Barbatronic/CDR-2027/DOCS/_posts/2026-09-21-elements-de-jeu.md

---
title: "Réception des éléments de jeu : boulets et pierres"
date: 2026-09-21
tags: [test]
description: "Premières observations sur les éléments de jeu reçus pour la Coupe de France de robotique 2027 : les boulets (balles de 45 mm) et les pierres (cartons de 32 × 11 × 11 cm)."
---

## Objectif

Je viens de recevoir les éléments de jeu, alors je note ici mes premières observations.

Petit point de vocabulaire : dans la nomenclature de la Coupe de France de robotique 2027, les balles de 45 mm s'appellent les « boulets » et les cartons de 32 × 11 × 11 cm les « pierres ».

## Premier élément : les boulets (balles de 45 mm)

### Commande des boulets

J'ai commandé sur Amazon des balles de magicien standard de 45 mm : [lien d'achat](https://amzn.to/4y9q3ZC).

### Réception des boulets

Les balles sont arrivées le 20 septembre dans un sachet sous vide, donc à la sortie elles étaient complètement compressées.

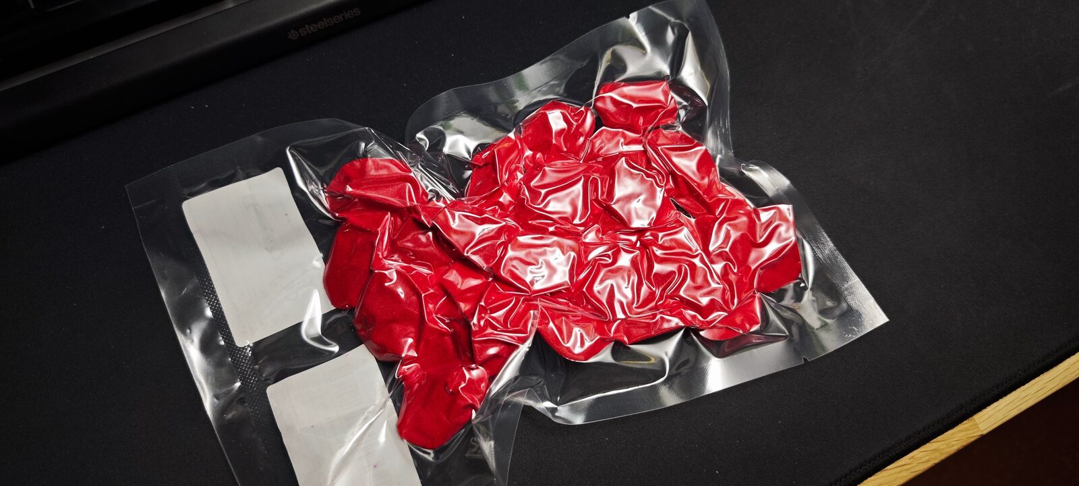
[picture p26: DOCS/assets/img/2026-09-21-elements-de-jeu/boulets-sachet-sous-vide.jpg]
Sachet sous vide contenant les balles compressées

*Le sachet sous vide à la réception.*

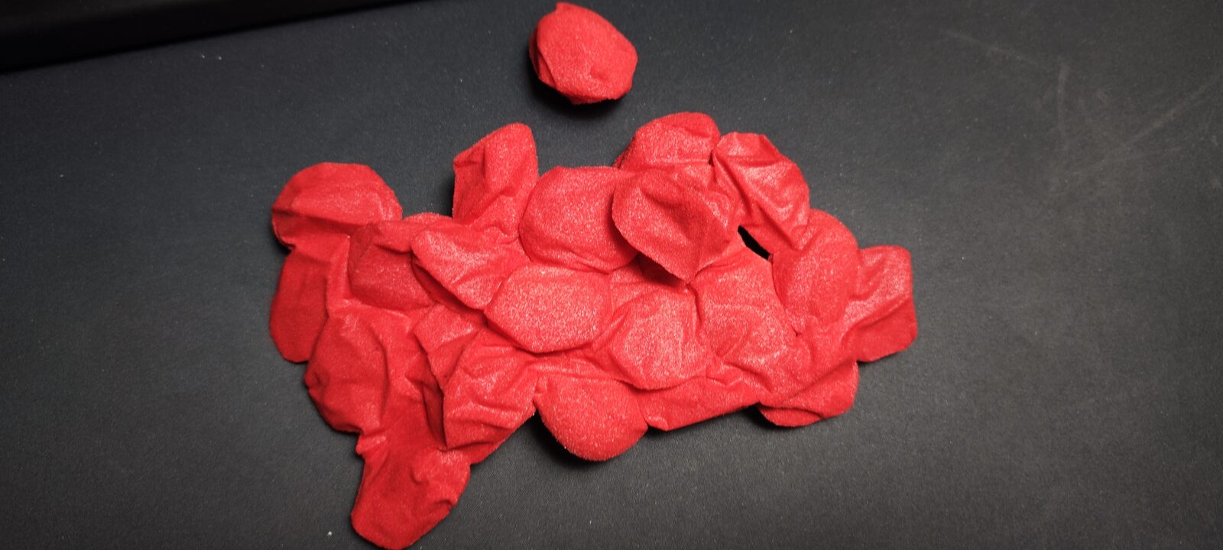
[picture p27: DOCS/assets/img/2026-09-21-elements-de-jeu/boulets-sortis-du-sachet.jpg]
Balles sorties du sachet, encore aplaties

*Les balles sorties du sachet, encore aplaties.*

### Reprise de forme

Je les ai simplement laissées au repos, sans rien faire de mon côté. Au bout d'une heure et demie à deux heures, elles avaient repris une forme à peu près sphérique.

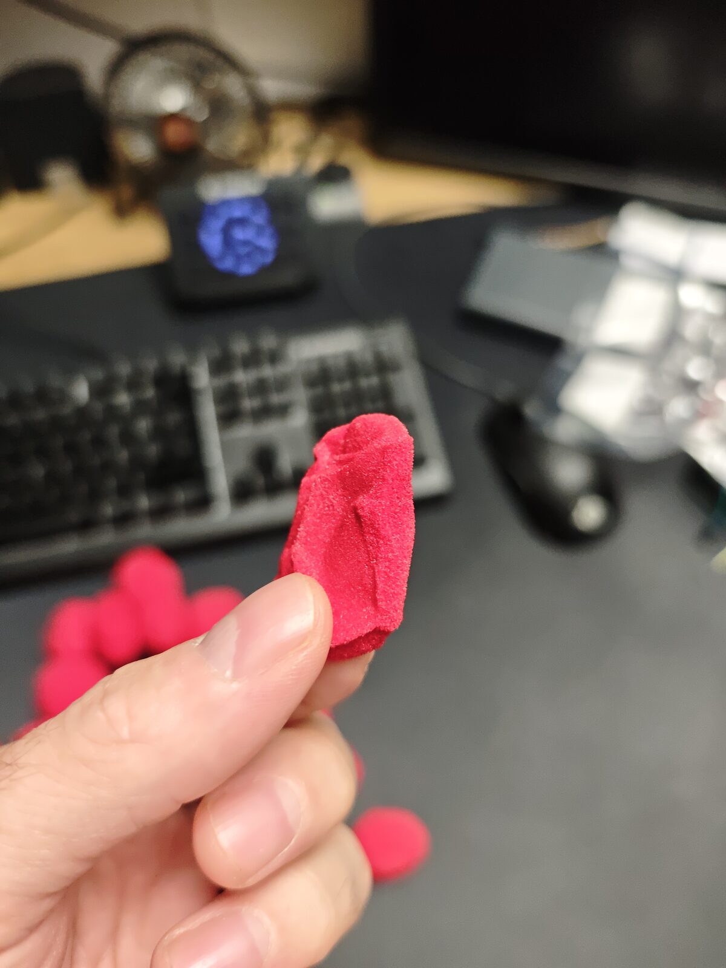
[picture p28: DOCS/assets/img/2026-09-21-elements-de-jeu/boulet-deforme-main.jpg]
Une balle déformée tenue entre les doigts

*Une balle encore déformée.*

### Mesures

Je les ai mesurées le lendemain de la réception, le 21 septembre, avec un pied à coulisse numérique.

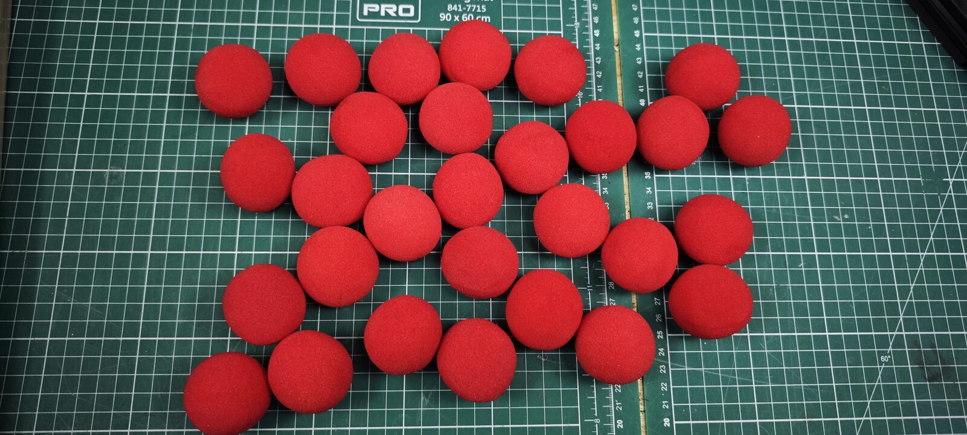
[picture p29: DOCS/assets/img/2026-09-21-elements-de-jeu/boulets-sur-tapis.jpg]
Les balles étalées sur un tapis de découpe

*Les balles après repos, étalées sur le tapis de découpe.*

Pour chaque balle, je fais trois mesures à des endroits différents.

#### Balle 1

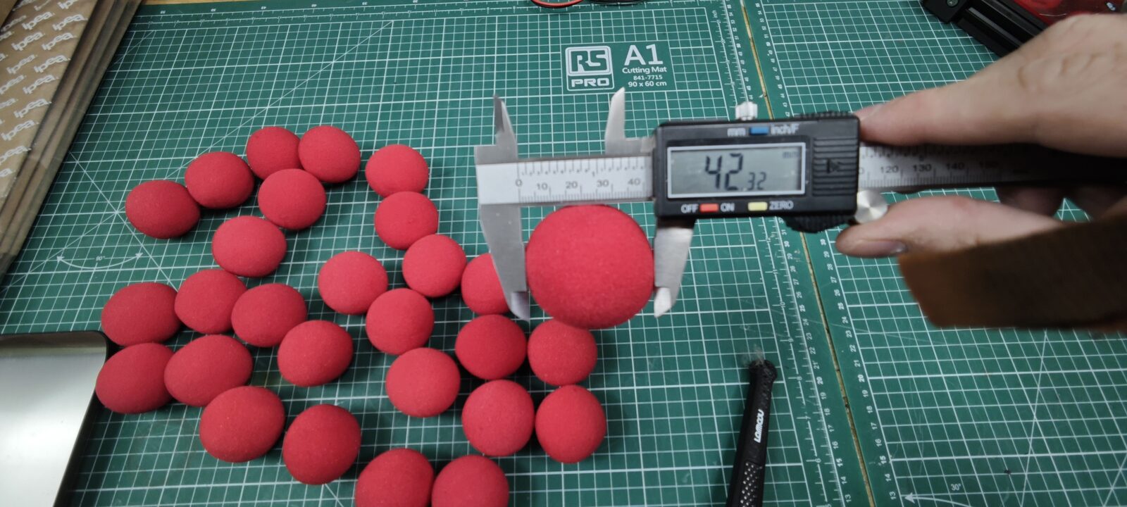
[picture p30: DOCS/assets/img/2026-09-21-elements-de-jeu/boulet-1-mesure-1.jpg]
Balle mesurée au pied à coulisse : 42,32 mm

*Mesure 1 : 42,32 mm.*

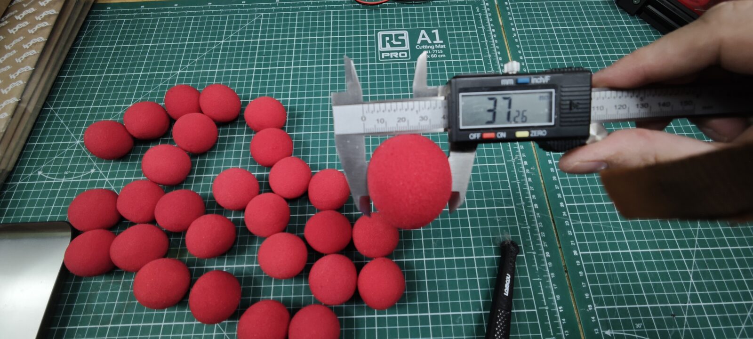
[picture p31: DOCS/assets/img/2026-09-21-elements-de-jeu/boulet-1-mesure-2.jpg]
Balle mesurée au pied à coulisse : 37,26 mm

*Mesure 2 : 37,26 mm.*

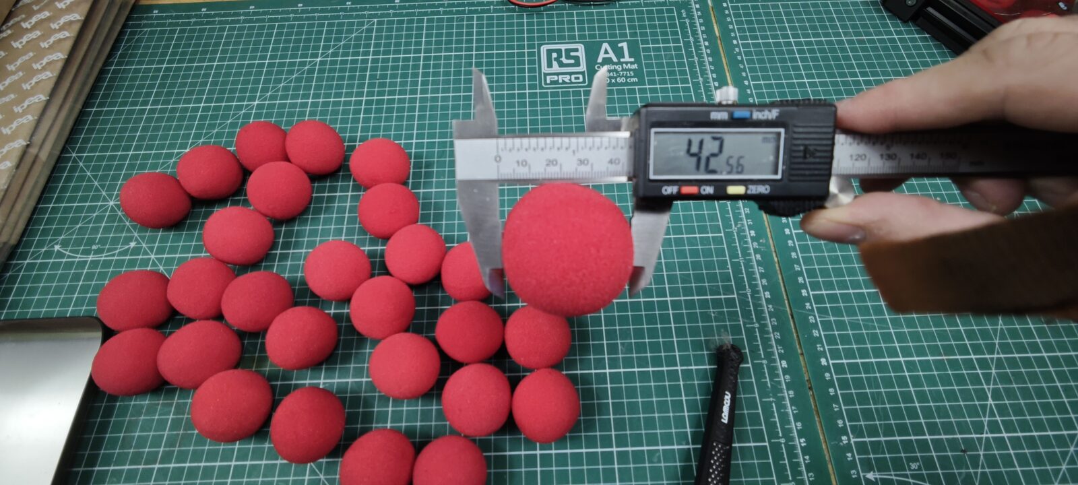
[picture p32: DOCS/assets/img/2026-09-21-elements-de-jeu/boulet-1-mesure-3.jpg]
Balle mesurée au pied à coulisse : 42,56 mm

*Mesure 3 : 42,56 mm.*

#### Balle 2

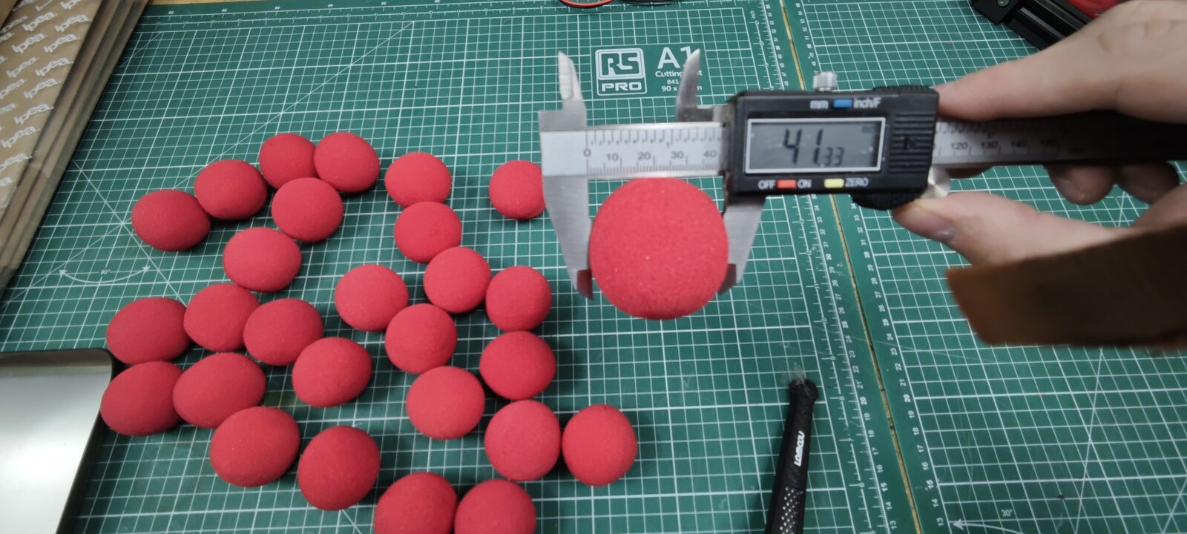
[picture p33: DOCS/assets/img/2026-09-21-elements-de-jeu/boulet-2-mesure-1.jpg]
Balle 2 mesurée au pied à coulisse : 41,33 mm

*Mesure 1 : 41,33 mm.*

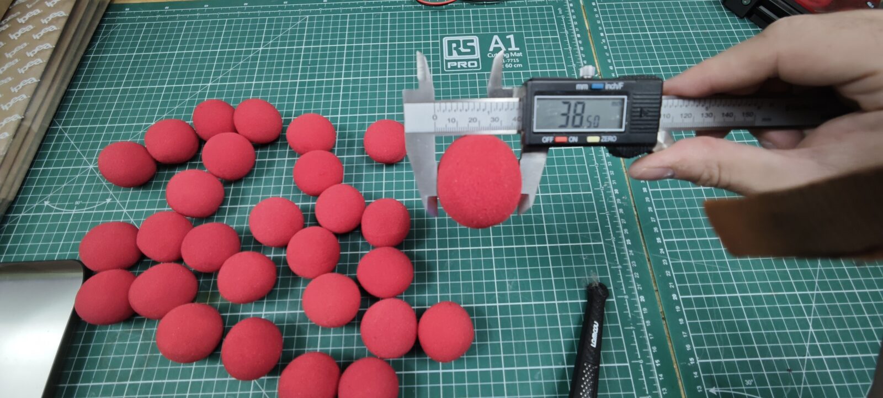
[picture p34: DOCS/assets/img/2026-09-21-elements-de-jeu/boulet-2-mesure-2.jpg]
Balle 2 mesurée au pied à coulisse : 38,50 mm

*Mesure 2 : 38,50 mm.*

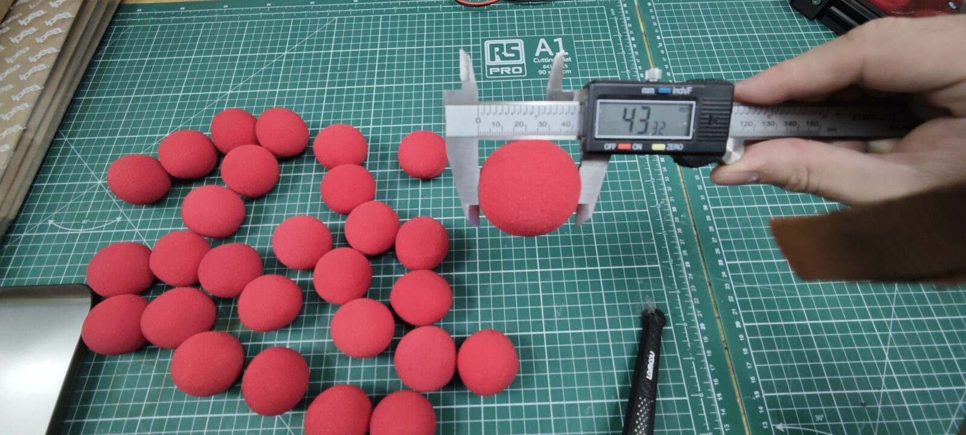
[picture p35: DOCS/assets/img/2026-09-21-elements-de-jeu/boulet-2-mesure-3.jpg]
Balle 2 mesurée au pied à coulisse : 43,32 mm

*Mesure 3 : 43,32 mm.*

#### Balle 3

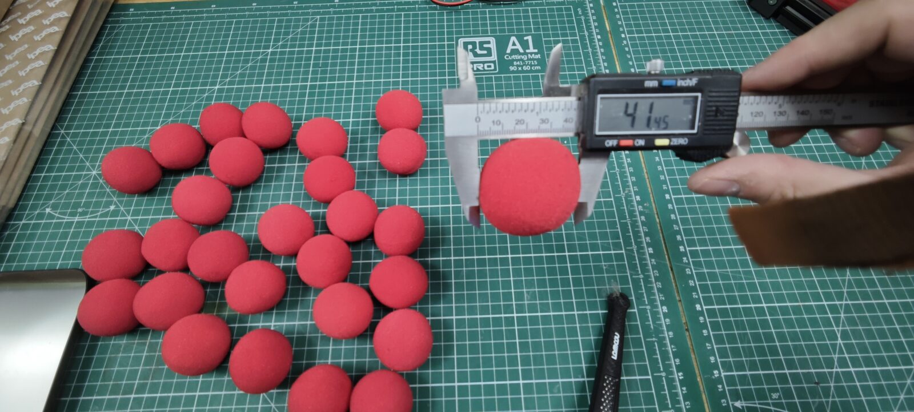
[picture p36: DOCS/assets/img/2026-09-21-elements-de-jeu/boulet-3-mesure-1.jpg]
Balle 3 mesurée au pied à coulisse : 41,45 mm

*Mesure 1 : 41,45 mm.*

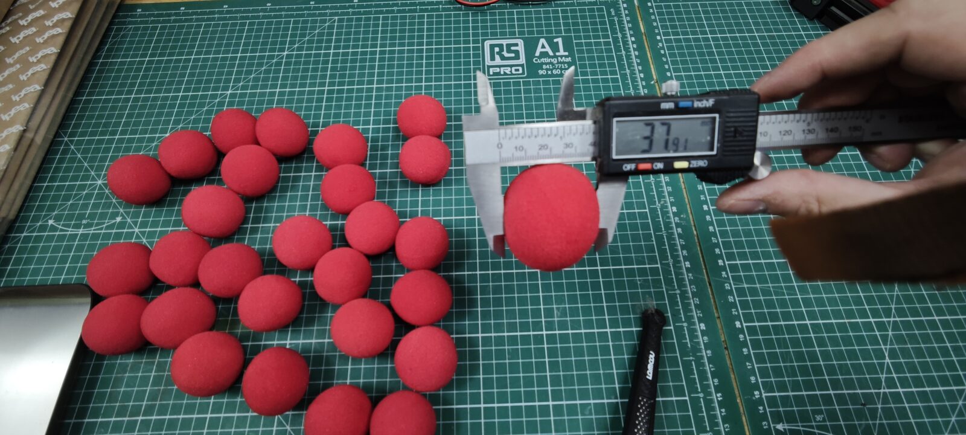
[picture p37: DOCS/assets/img/2026-09-21-elements-de-jeu/boulet-3-mesure-2.jpg]
Balle 3 mesurée au pied à coulisse : 37,91 mm

*Mesure 2 : 37,91 mm.*

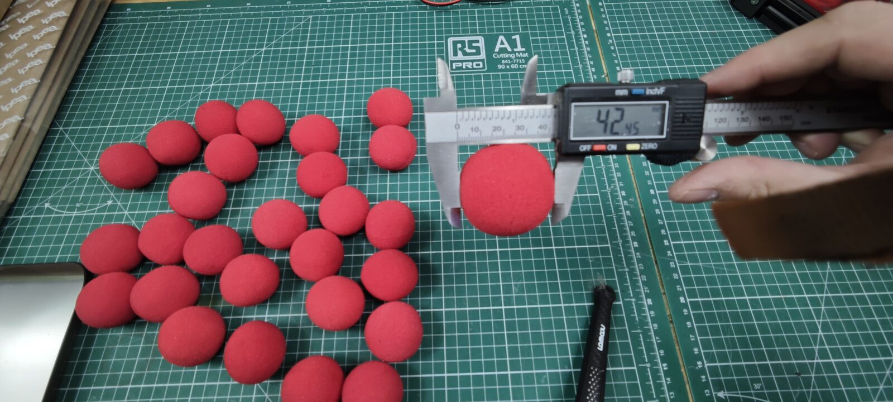
[picture p38: DOCS/assets/img/2026-09-21-elements-de-jeu/boulet-3-mesure-3.jpg]
Balle 3 mesurée au pied à coulisse : 42,45 mm

*Mesure 3 : 42,45 mm.*

#### Récapitulatif

| Balle | Mesure 1 | Mesure 2 | Mesure 3 | Écart max. |
|---|---|---|---|---|
| 1 | 42,32 mm | 37,26 mm | 42,56 mm | 5,30 mm |
| 2 | 41,33 mm | 38,50 mm | 43,32 mm | 4,82 mm |
| 3 | 41,45 mm | 37,91 mm | 42,45 mm | 4,54 mm |

Sur les trois balles, toutes les mesures sont sous les 45 mm (43,32 mm au maximum), et les balles ne sont clairement pas rondes : pour une même balle, l'écart entre la plus petite et la plus grande mesure va de 4,54 mm à 5,30 mm.

### Poids des boulets

Les balles sont très légères, alors je les ai pesées par groupes de trois, avec à chaque fois trois balles différentes. La balance est précise au centième de gramme.

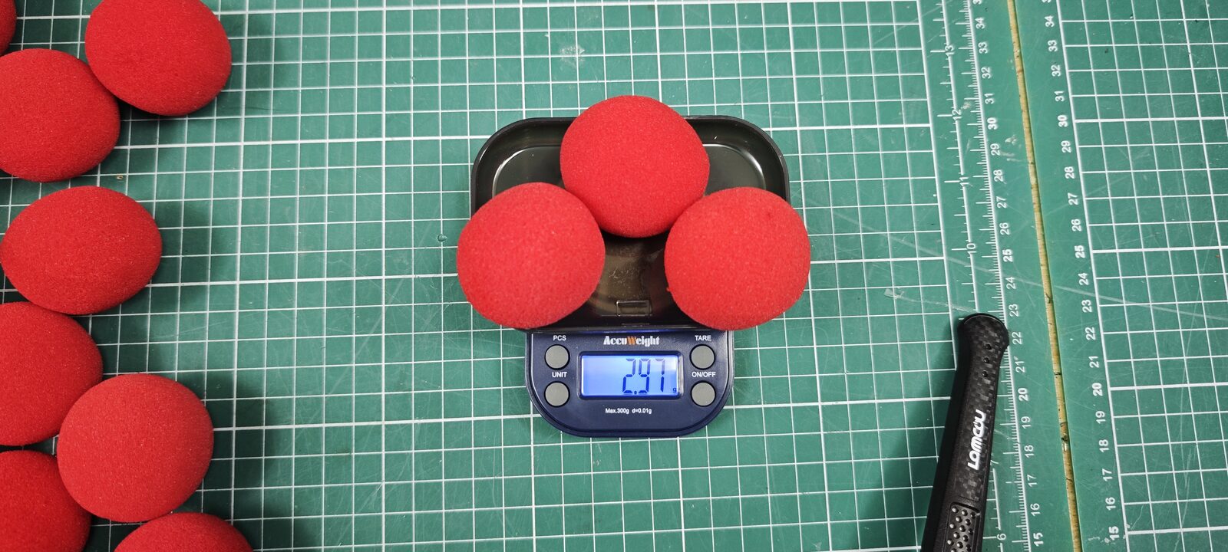
[picture p39: DOCS/assets/img/2026-09-21-elements-de-jeu/boulets-pesee-1.jpg]
Pesée 1 : trois balles sur la balance, 2,97 g

*Pesée 1 : 2,97 g pour trois balles.*

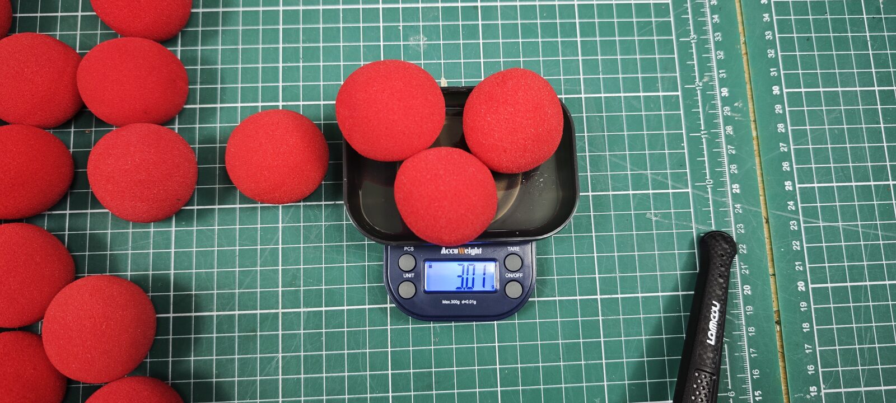
[picture p40: DOCS/assets/img/2026-09-21-elements-de-jeu/boulets-pesee-2.jpg]
Pesée 2 : trois balles sur la balance, 3,01 g

*Pesée 2 : 3,01 g pour trois balles.*

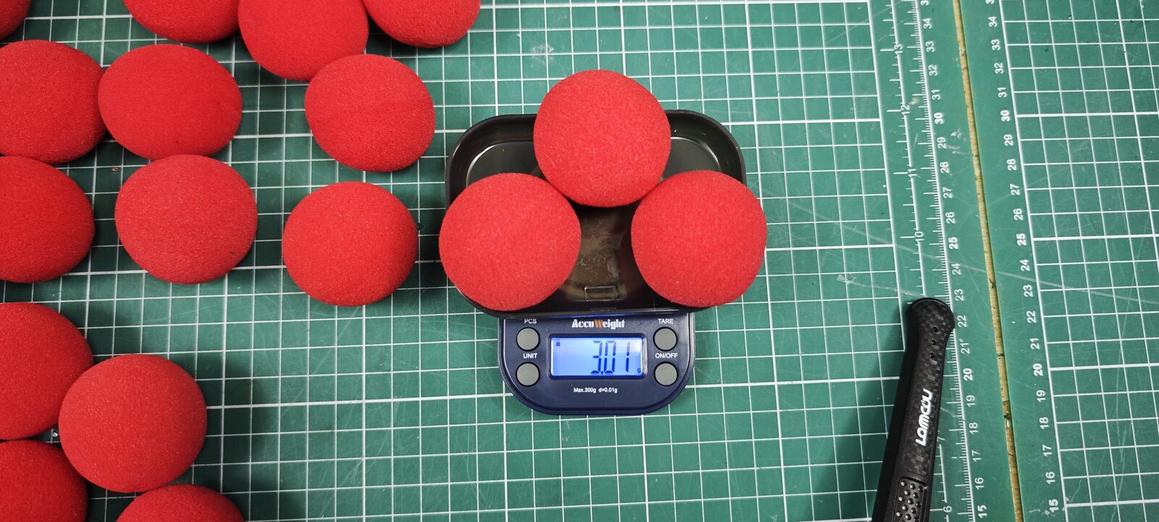
[picture p41: DOCS/assets/img/2026-09-21-elements-de-jeu/boulets-pesee-3.jpg]
Pesée 3 : trois balles sur la balance, 3,01 g

*Pesée 3 : 3,01 g pour trois balles.*

| Pesée | Masse de 3 balles | Masse moyenne par balle |
|---|---|---|
| 1 | 2,97 g | 0,99 g |
| 2 | 3,01 g | 1,00 g |
| 3 | 3,01 g | 1,00 g |

Au total, ça fait 8,99 g pour 9 balles, soit environ 1 g par balle.

## Deuxième élément : les pierres (cartons de 32 × 11 × 11 cm)

### Commande des pierres

Le deuxième élément de jeu est un carton, qui doit normalement faire 32 × 11 × 11 cm.

Sur le lien d'achat, l'annonce parle de cartons de 30 × 10 × 10 cm : [lien d'achat](https://amzn.to/4hB10bT). J'ai pris le risque de les commander pour tester, en me disant que c'étaient peut-être les dimensions intérieures.

### Réception des pierres

En fait, sur cette référence, le carton reçu est celui du fabricant Raja, référence BLFA01. Les dimensions sont marquées dessus : 31 × 10,5 × 10,5 cm, et ce sont bien celles qu'on retrouve chez le fabricant.

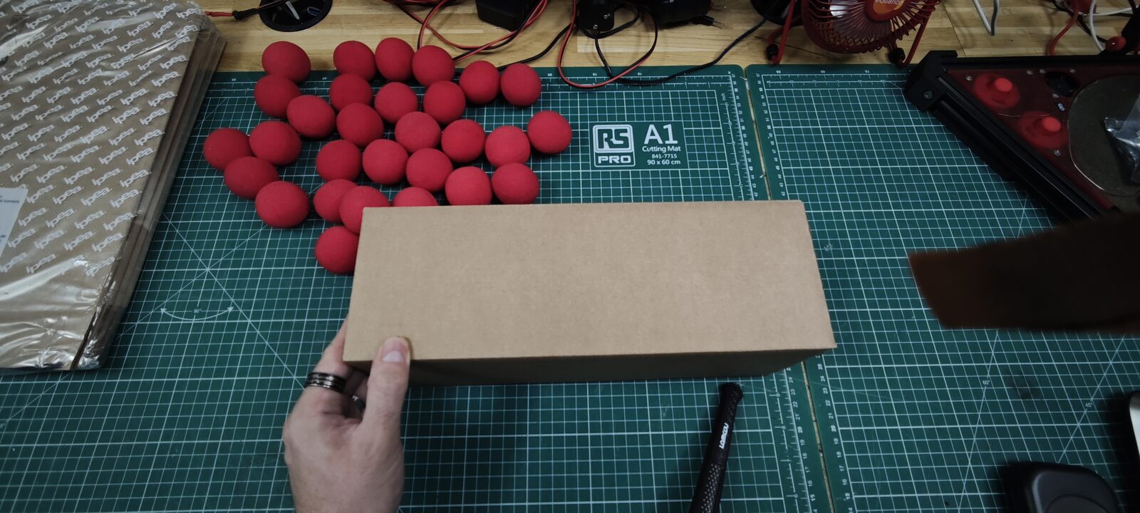
[picture p42: DOCS/assets/img/2026-09-21-elements-de-jeu/pierre-sur-tapis.jpg]
Le carton posé sur le tapis de découpe

*Le carton posé sur le tapis de découpe.*

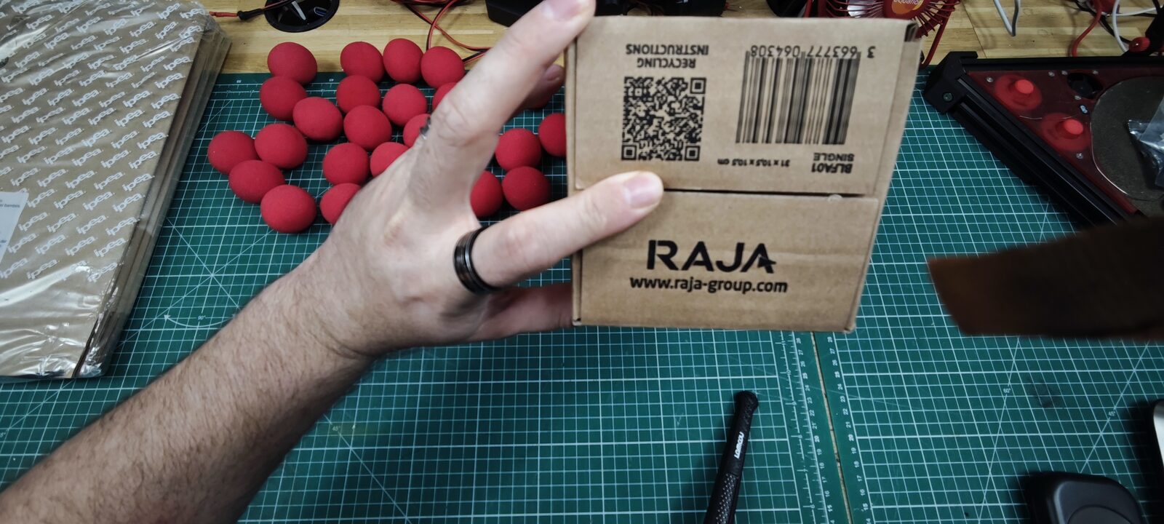
[picture p43: DOCS/assets/img/2026-09-21-elements-de-jeu/pierre-extremite-etiquette.jpg]
Une extrémité du carton, avec le logo Raja et l'étiquette

*Une extrémité du carton, avec le logo Raja et l'étiquette.*

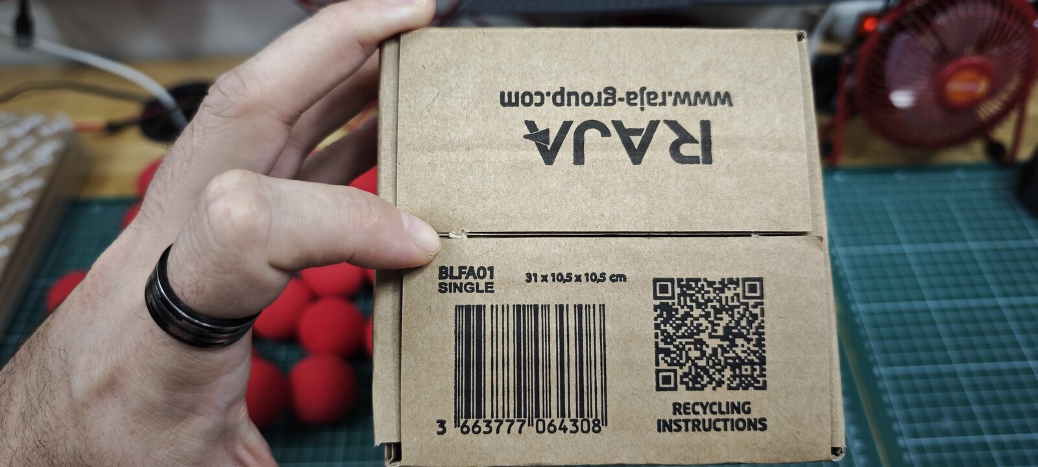
[picture p44: DOCS/assets/img/2026-09-21-elements-de-jeu/pierre-etiquette-gros-plan.jpg]
Gros plan sur l'étiquette : BLFA01, 31 x 10,5 x 10,5 cm

*Gros plan sur l'étiquette : BLFA01, 31 x 10,5 x 10,5 cm.*

### Mesure au mètre

J'ai mesuré le carton au mètre ruban, à l'extérieur : il fait environ 32 cm de long et 11 cm de côté.

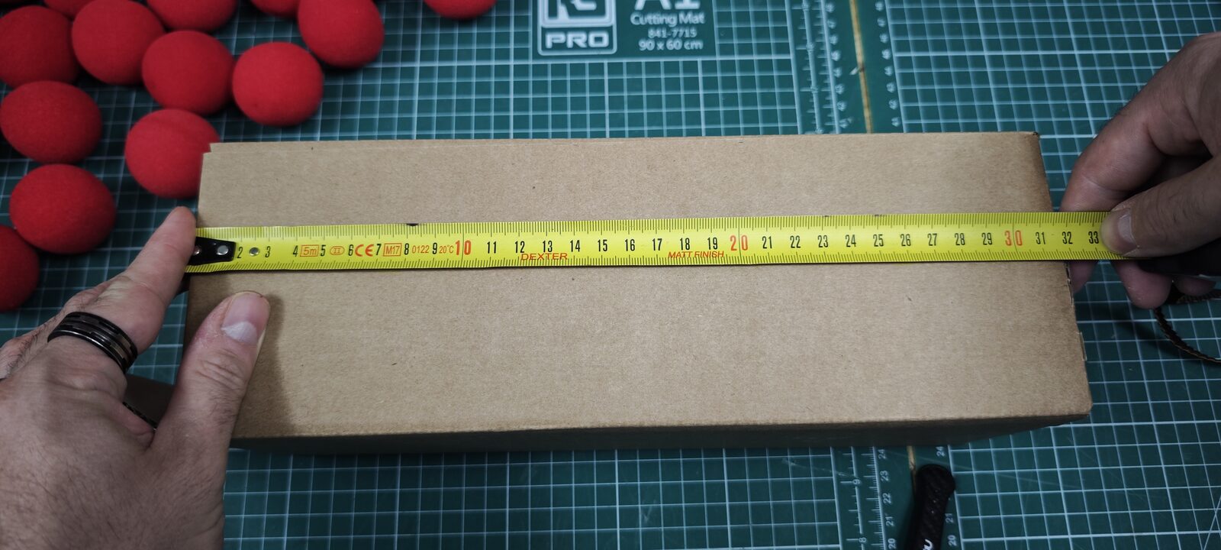
[picture p45: DOCS/assets/img/2026-09-21-elements-de-jeu/pierre-mesure-longueur.jpg]
Mesure de la longueur du carton au mètre ruban : environ 32 cm

*Longueur : environ 32 cm.*

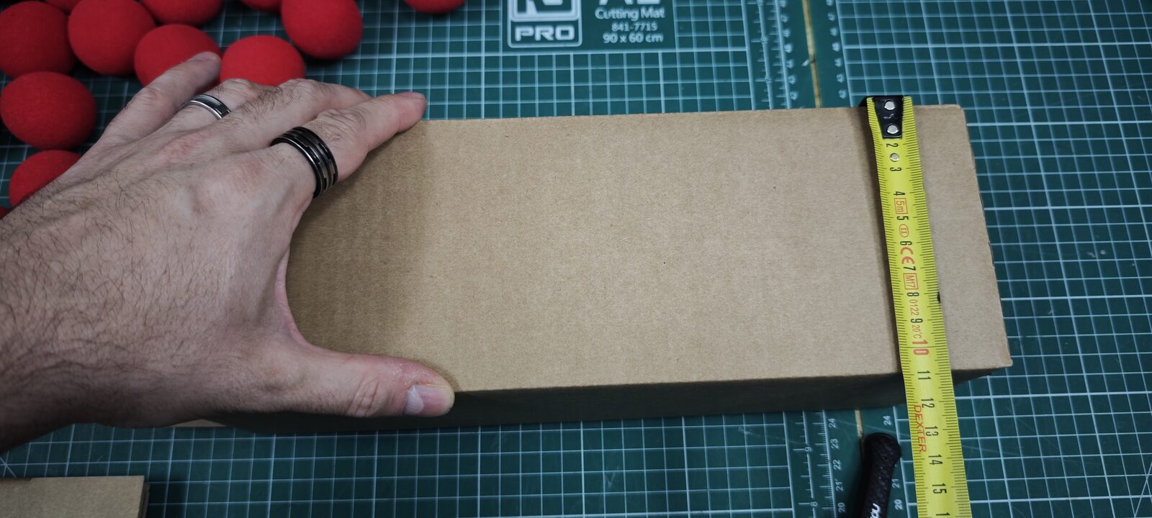
[picture p46: DOCS/assets/img/2026-09-21-elements-de-jeu/pierre-mesure-cote.jpg]
Mesure d'un côté du carton au mètre ruban : environ 11 cm

*Côté : environ 11 cm.*

### Comparaison des dimensions

| Source | Dimensions | Écart avec l'élément de jeu |
|---|---|---|
| Élément de jeu attendu | 32 × 11 × 11 cm | – |
| Annonce du lien d'achat | 30 × 10 × 10 cm | −2 × −1 × −1 cm |
| Marquage du carton (Raja BLFA01) | 31 × 10,5 × 10,5 cm | −1 × −0,5 × −0,5 cm |
| Mesure au mètre (dimensions extérieures) | environ 32 × 11 cm  | environ 0 cm |

Bref, quelles que soient les dimensions annoncées par le lien d'achat ou marquées sur le carton, il fait bien environ 32 × 11 cm à l'extérieur, et c'est ce qu'on attend d'une pierre.

### Aspect extérieur

**Petits côtés.** Sur un des petits côtés, le carton est un peu renfoncé, et c'est très difficile de le rendre complètement plan. Il faudra en tenir compte pour la manipulation et pour la dépose de la pierre.

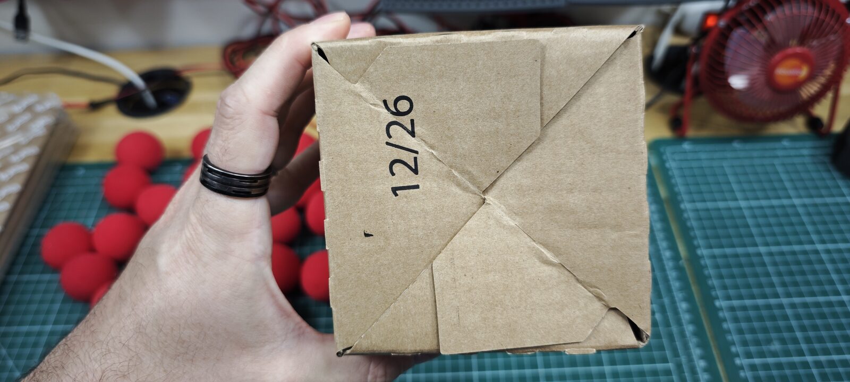
[picture p47: DOCS/assets/img/2026-09-21-elements-de-jeu/pierre-petit-cote.jpg]
Un petit côté du carton, avec les rabats repliés

*Un petit côté : les rabats repliés laissent des plis et la face n'est pas plane.*

**Longs côtés.** Sur les longs côtés, rien à dire : le carton est plutôt rigide et plan. Il y a un petit surplus dû au rabat d'un côté, mais il se fait sur une arête et il ne semble pas gênant a priori.

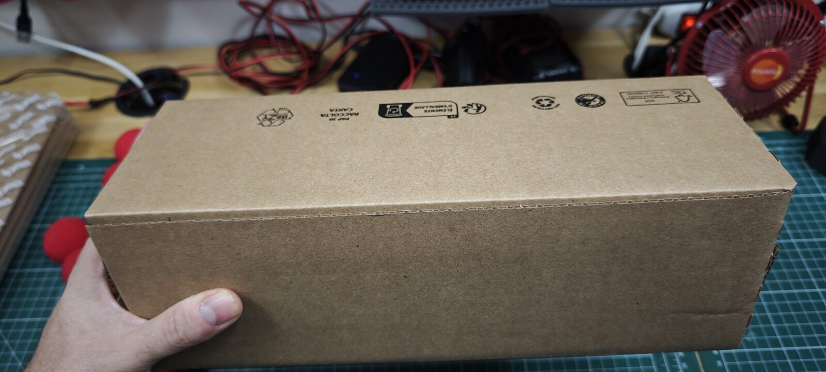
[picture p48: DOCS/assets/img/2026-09-21-elements-de-jeu/pierre-long-cote-rabat.jpg]
Un long côté du carton, avec le recouvrement du rabat

*Un long côté : le recouvrement du rabat se voit le long d'une arête.*

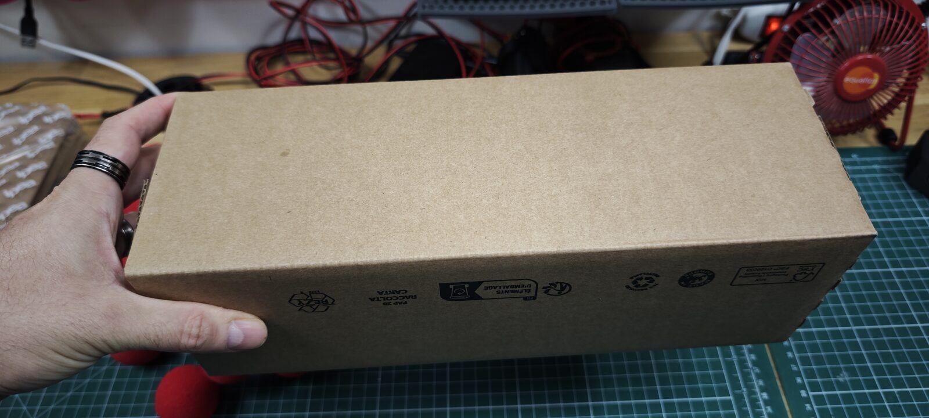
[picture p49: DOCS/assets/img/2026-09-21-elements-de-jeu/pierre-long-cote-marquages.jpg]
Un long côté du carton, avec les marquages d'emballage

*Un long côté, avec les marquages d'emballage.*

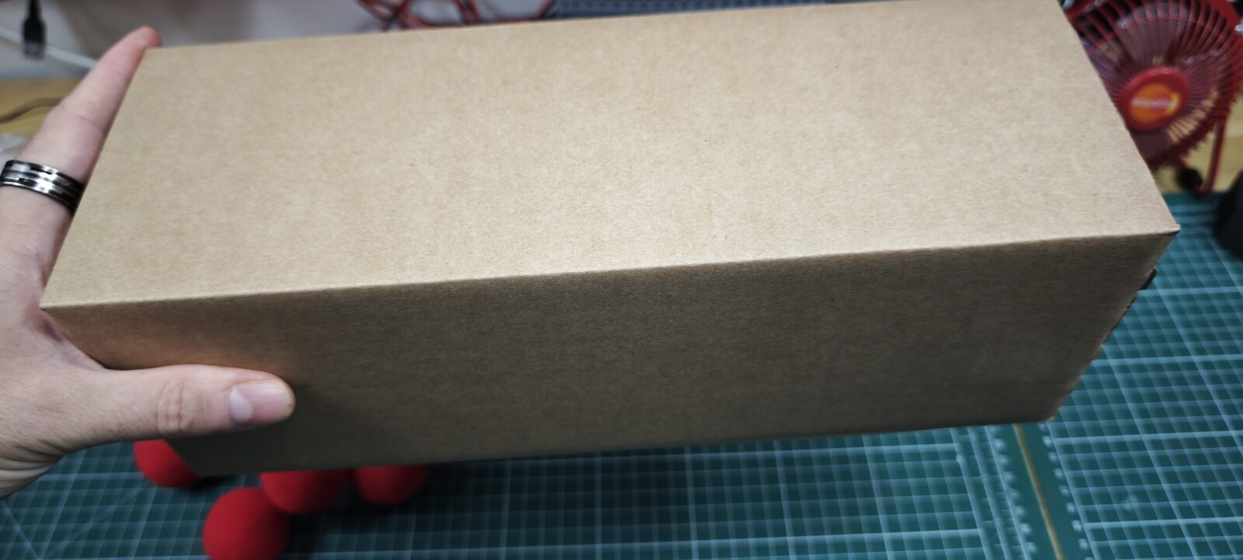
[picture p50: DOCS/assets/img/2026-09-21-elements-de-jeu/pierre-long-cote-plan.jpg]
Un long côté du carton, plan

*Un long côté, plan.*

### Poids des pierres

D'après le règlement, une pierre pèse environ 90 g. J'ai pesé un carton : la balance affiche 76 g, soit 14 g de moins que les 90 g attendus (environ 16 %). Mes cartons sont donc plus légers que prévu.

Il y a une explication possible : je n'ai pas encore mis sur ces cartons la surface autocollante avec les tags de reconnaissance. Or les pierres portent du vinyle avec des QR codes, et ce vinyle peut ajouter du poids. C'est peut-être en partie ce qui explique la différence.

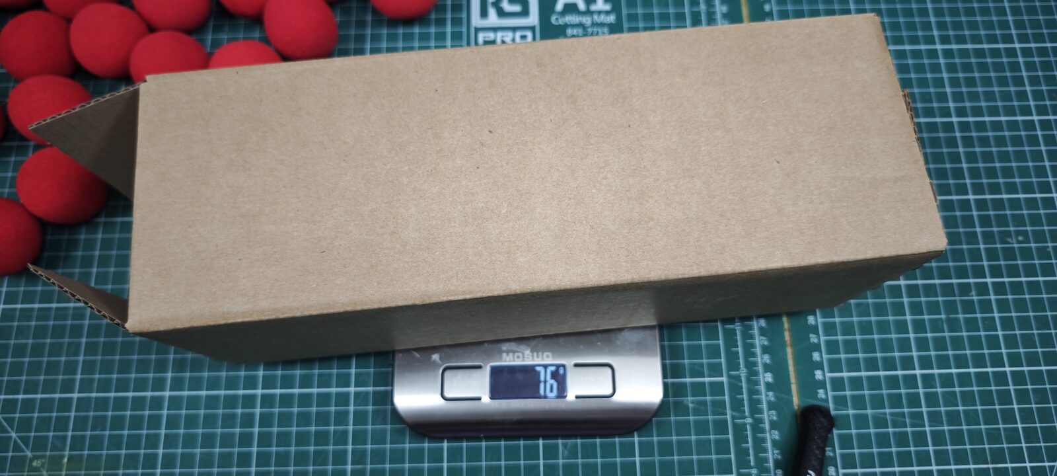
[picture p51: DOCS/assets/img/2026-09-21-elements-de-jeu/pierre-pesee.jpg]
Le carton posé sur une balance, 76 g

*Le carton sur la balance : 76 g.*

### Empilement de trois pierres

J'ai empilé trois cartons, comme ils seront sur le terrain, à côté de mon robot de l'année dernière pour donner une idée de l'échelle.

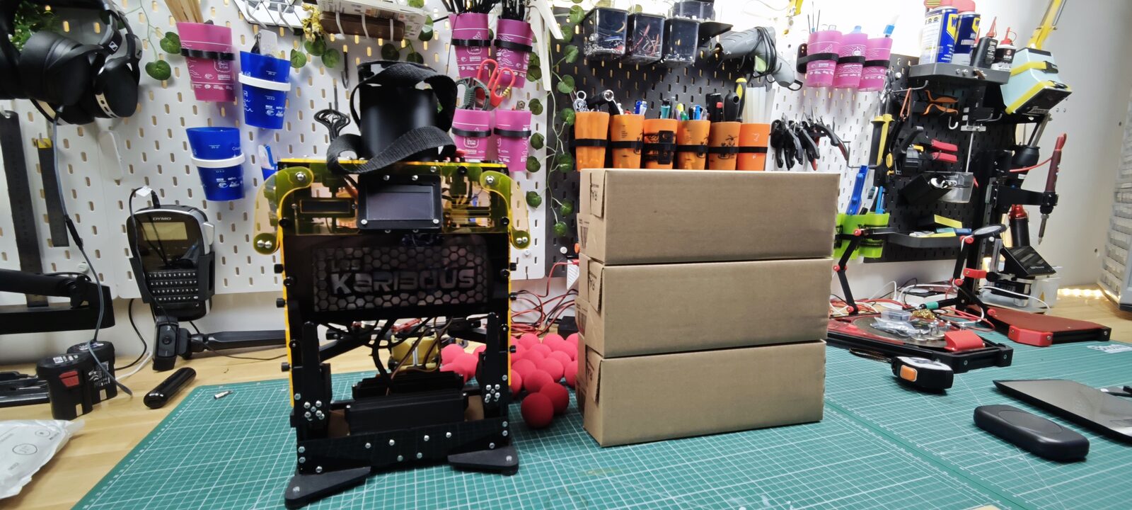
[picture p52: DOCS/assets/img/2026-09-21-elements-de-jeu/pierres-empilees-face.jpg]
Trois cartons empilés à côté du robot de l'année dernière, vue de face

*Les trois cartons empilés à côté de mon robot de l'année dernière, vue de face.*

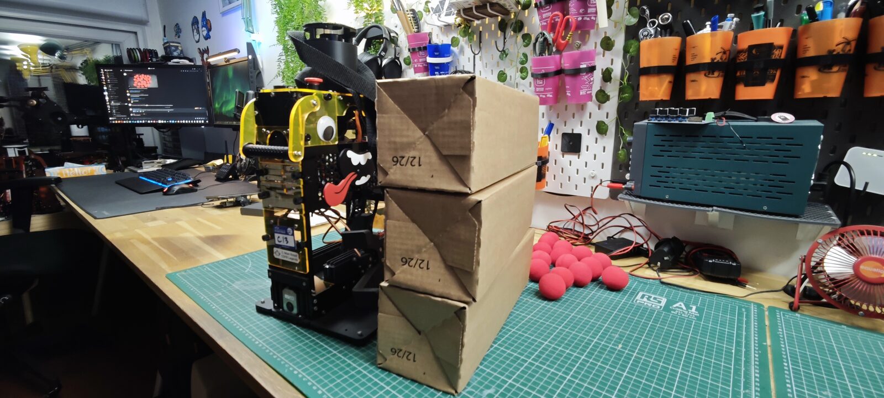
[picture p53: DOCS/assets/img/2026-09-21-elements-de-jeu/pierres-empilees-trois-quarts.jpg]
Trois cartons empilés à côté du robot de l'année dernière, vue de trois quarts

*Les mêmes, vus de trois quarts : on voit les rabats repliés en bout de carton.*

Ici, j'ai fermé chaque carton en croisant les rabats à chaque bout. Je ne sais pas comment les cartons seront fermés sur le terrain : scotchés pour être complètement fermés, collés, ou avec des rabats croisés comme dans mon montage ?

Selon la façon dont le carton est fabriqué, il est plus ou moins trapézoïdal, ou au contraire bien rectangulaire et droit. Du coup, une fois empilés par trois, on peut avoir une légère courbure, avec un mur qui n'est pas parfaitement droit. Il faudra en tenir compte dans la conception.

Autre point : les cartons glissent assez facilement les uns sur les autres. Là aussi, il faudra en tenir compte dans la conception, surtout si on veut une prise par ventouse.

#### Essai de tir sur le mur

J'ai envoyé des balles en mousse, à environ 80 cm, le plus fort possible, directement sur le mur de trois cartons, pour voir s'il tombait. Résultat : il ne tombe pas du tout. Un léger mouvement mais à peine. Je doute qu'à 2m de distance et en cloche les balles arrivent à détruire une construction adverse.

<video controls preload="metadata" playsinline width="100%">
  <source src="{{ '/assets/img/2026-09-21-elements-de-jeu/pierres-tir-sur-le-mur.mp4' | relative_url }}" type="video/mp4">
  Votre navigateur ne sait pas lire cette vidéo.
</video>

*Tirs de balles en mousse sur le mur de trois cartons : il reste debout.*

Une seconde vidéo, plus pour la blague, montre que je tape vraiment très fort : j'essaie réellement de les renverser :D

<video controls preload="metadata" playsinline width="100%">
  <source src="{{ '/assets/img/2026-09-21-elements-de-jeu/pierres-tir-demonstration.mp4' | relative_url }}" type="video/mp4">
  Votre navigateur ne sait pas lire cette vidéo.
</video>

## Conclusion

**Boulets :** Il va falloir que je fasse un essai de lancer de balles avec deux moteurs, pour voir ce que ça donne. Mais clairement, on ne peut pas compter sur la sphéricité des balles.

**Pierres :** Les murs de trois me semblent faciles à prendre, et il existe pas mal de solutions possibles. En revanche, le positionnement en colonne, donc bien droit et à la verticale, me semble assez aléatoire, selon le choix des côtés du carton.

Il reste une crainte : que les cartons s'abîment au fur et à mesure. Je fais confiance à l'organisation de la Coupe pour le repérer et les changer si nécessaire.

Enfin, je n'ai pas encore mis la surface autocollante avec les tags de reconnaissance sur mes cartons. Ça va probablement aussi changer leur comportement.
