Barbatronic/CDR-2027/DOCS/_posts/2026-09-22-portes-et-colonnes.md

---
title: "Essais des éléments de jeu : portes et colonnes"
date: 2026-09-22
tags: [test]
description: "Premiers essais des portes et des colonnes, éléments de jeu de la Coupe de France de robotique 2027."
---

## Objectif

À la demande d'Astérix (RCVA) sur le Discord de la coupe, j'ai fait quelques essais rapides sur deux autres constructions possibles avec les pierres : la porte et la tour.

## Premier élément : la porte

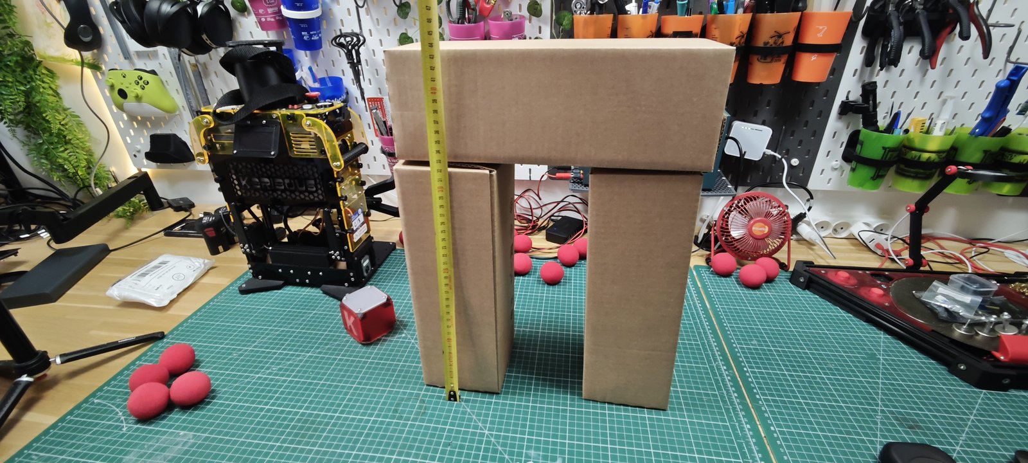
[picture p58: DOCS/assets/img/2026-09-22-portes-et-colonnes/porte-vue-ensemble.jpg]
Vue d'ensemble de la porte en construction, mesurée au mètre ruban

*La porte en construction, mesurée au mètre ruban.*

En l'état, j'arrive à une hauteur de 43,9 cm, à cause du renflement du carton sur le dessus.

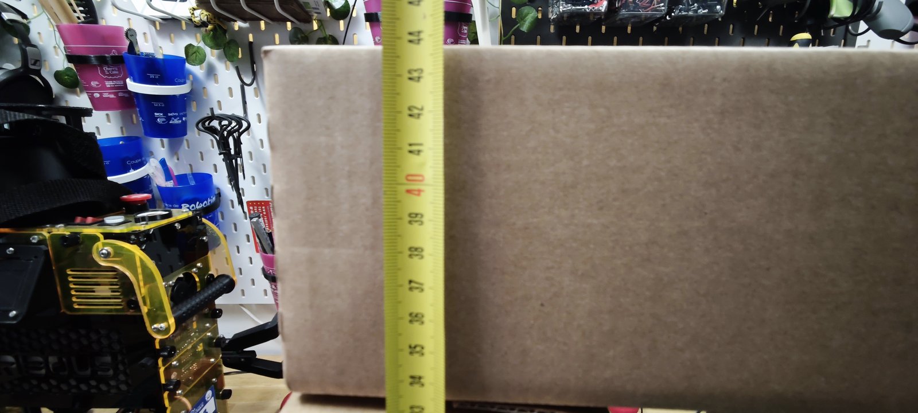
[picture p59: DOCS/assets/img/2026-09-22-portes-et-colonnes/porte-mesure-hauteur.jpg]
Gros plan sur la mesure au mètre ruban, un peu en dessous de 44 cm

*Gros plan sur la mesure : environ 43,9 cm.*

L'ensemble tient, mais on sent qu'il ne faut pas grand-chose pour que ça tombe :D

## Deuxième élément : la tour

J'ai aussi testé de lancer des balles sur une tour.

<video controls preload="metadata" playsinline width="100%">
  <source src="{{ '/assets/img/2026-09-22-portes-et-colonnes/colonne-tir-balles.mp4' | relative_url }}" type="video/mp4">
  Votre navigateur ne sait pas lire cette vidéo.
</video>

*Tirs de balles en mousse sur une tour.*

C'est plus instable qu'un mur, évidemment, mais je doute qu'une balle lancée depuis le terrain ou par un PAMI puisse vraiment impacter la construction. Par contre, selon l'état du carton sur le petit côté (renflement, plis...), ça change pas mal la donne.

## Conclusion

**Porte :** la construction tient, mais elle reste fragile, avec une hauteur d'environ 43,9 cm causée par le renflement du carton en haut de la porte.

**Tour :** plus instable qu'un mur face à un tir de balle, mais probablement pas de quoi la faire tomber depuis une distance de tir réaliste. Le principal facteur reste l'état du petit côté des cartons utilisés.
