Barbatronic/CDR-2027/Claude outputs/apercu-gerbers.png

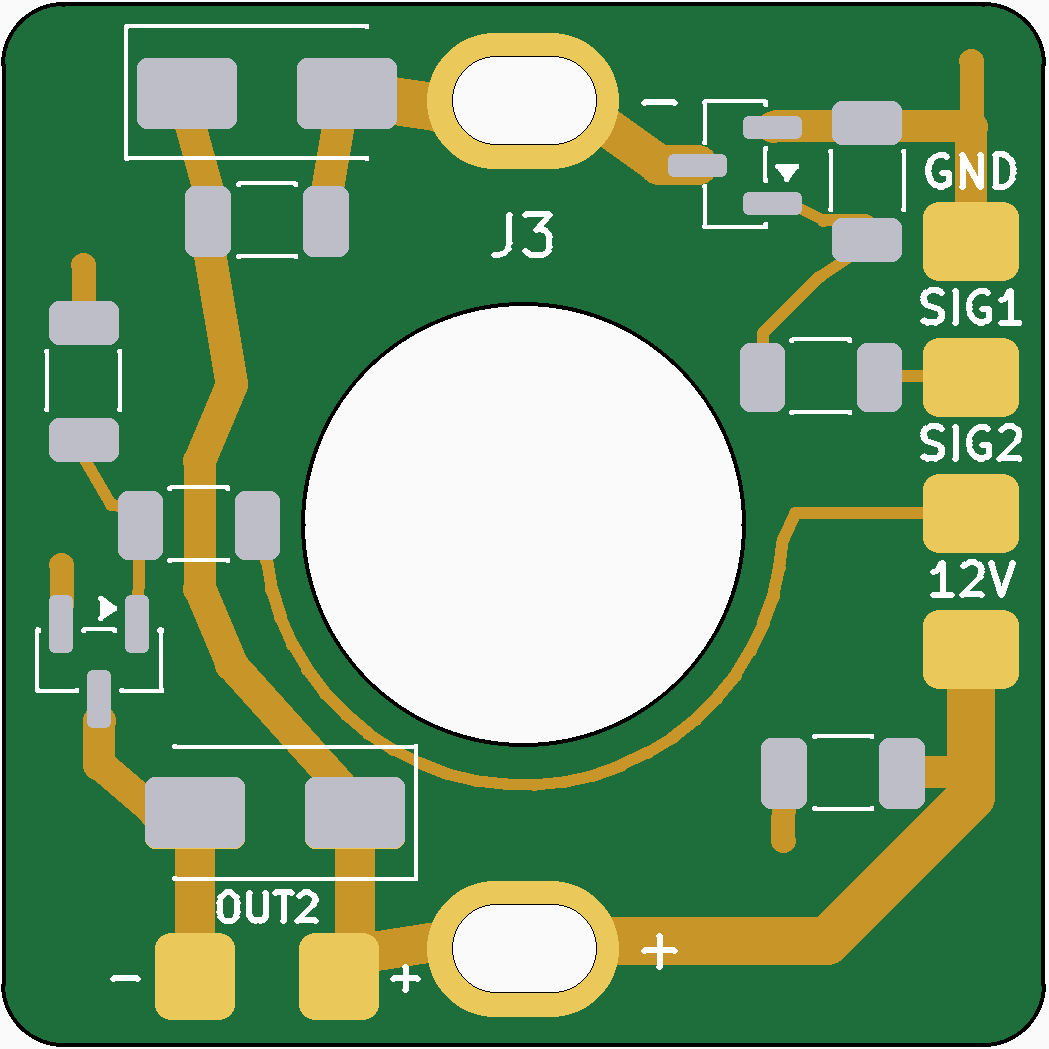
Claude outputs/apercu-gerbers.png
