Barbatronic/CDR-2027/Claude outputs/apercu-placement-routage.png

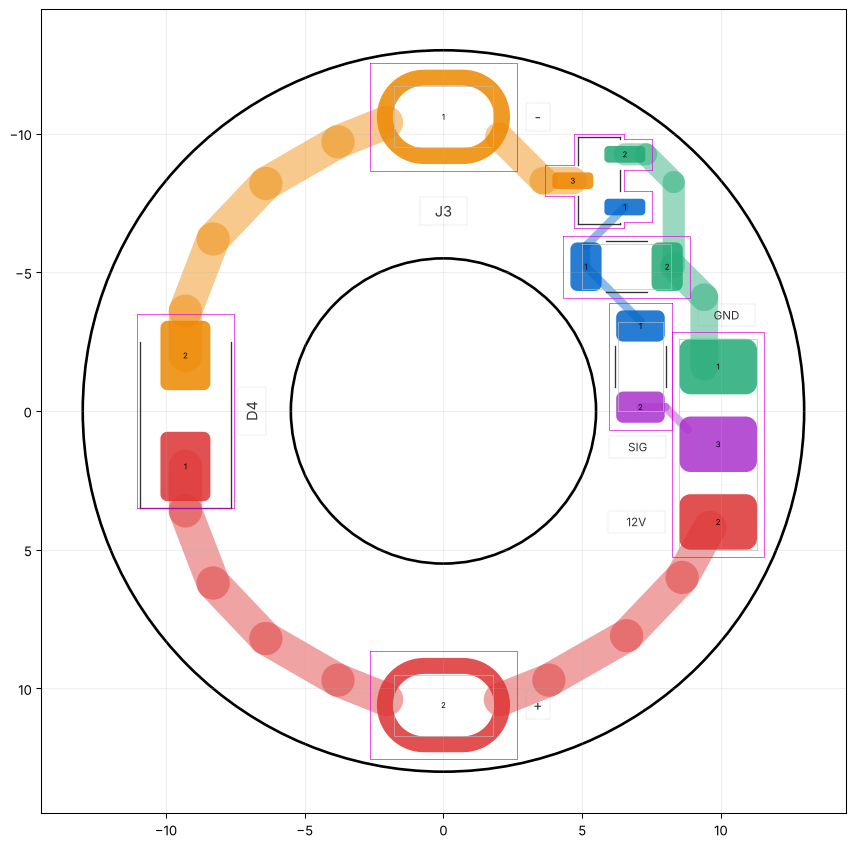
Claude outputs/apercu-placement-routage.png
