Barbatronic/CDR-2027/ECAD/main-board-2027/3dmodels/BOB-12009_kit_headers_KiCad10/BOB-12009_apercu.png

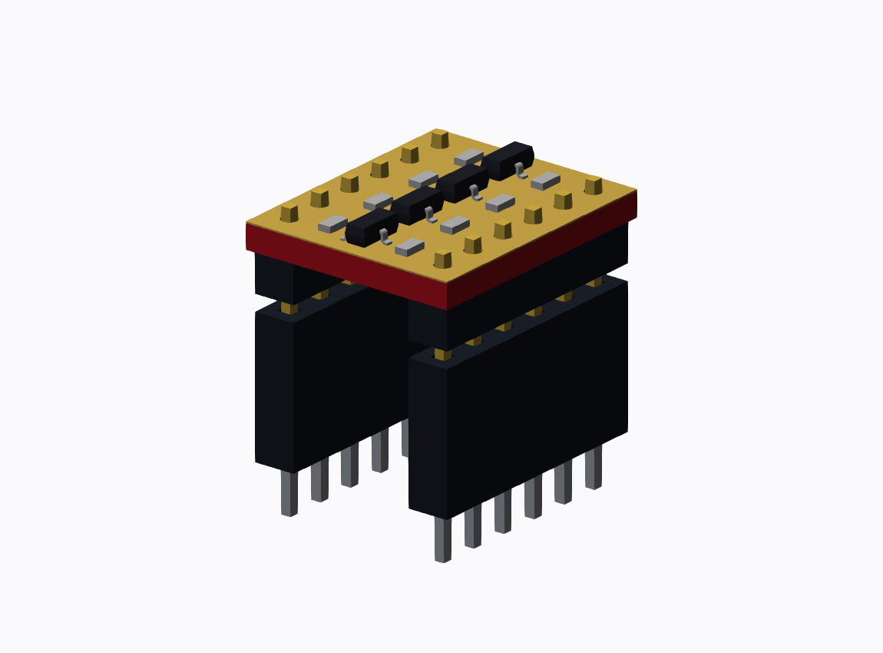
ECAD/main-board-2027/3dmodels/BOB-12009_kit_headers_KiCad10/BOB-12009_apercu.png
