Barbatronic/CDR-2027/FRW/Differential-Robot-Firmware/data/field.jpg

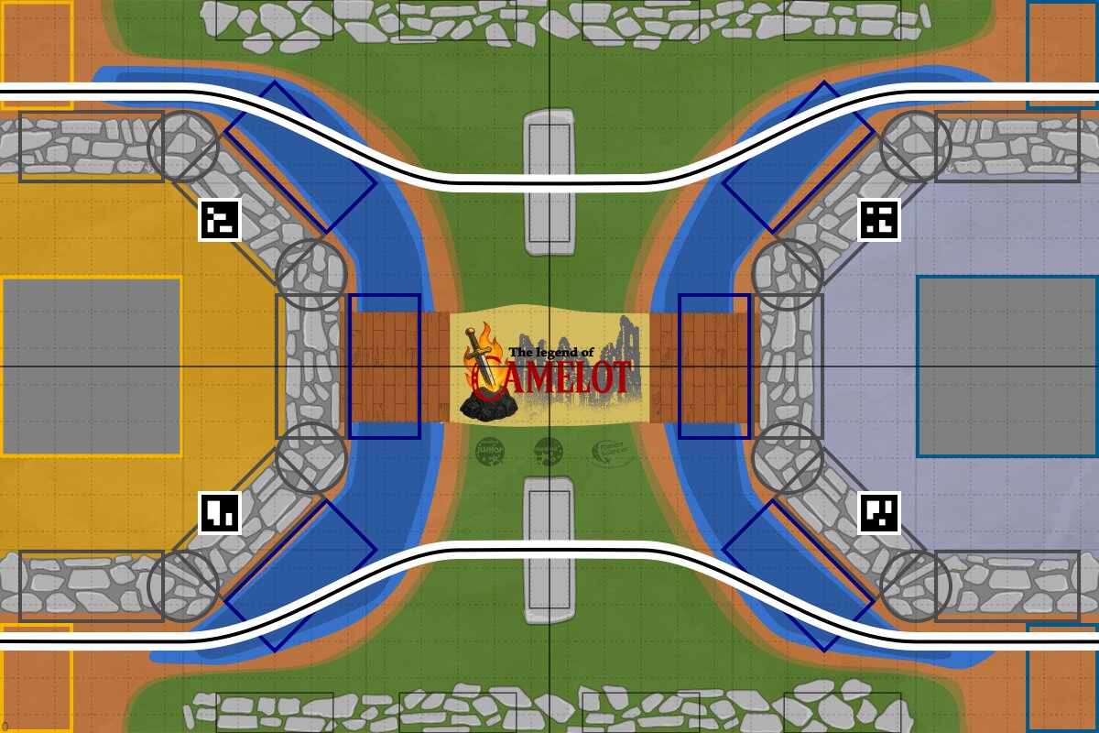
FRW/Differential-Robot-Firmware/data/field.jpg
