Barbatronic/CDR-2027/MCAD/electronical-parts/ImagesBatterie/IMG_20250729_205804.jpg

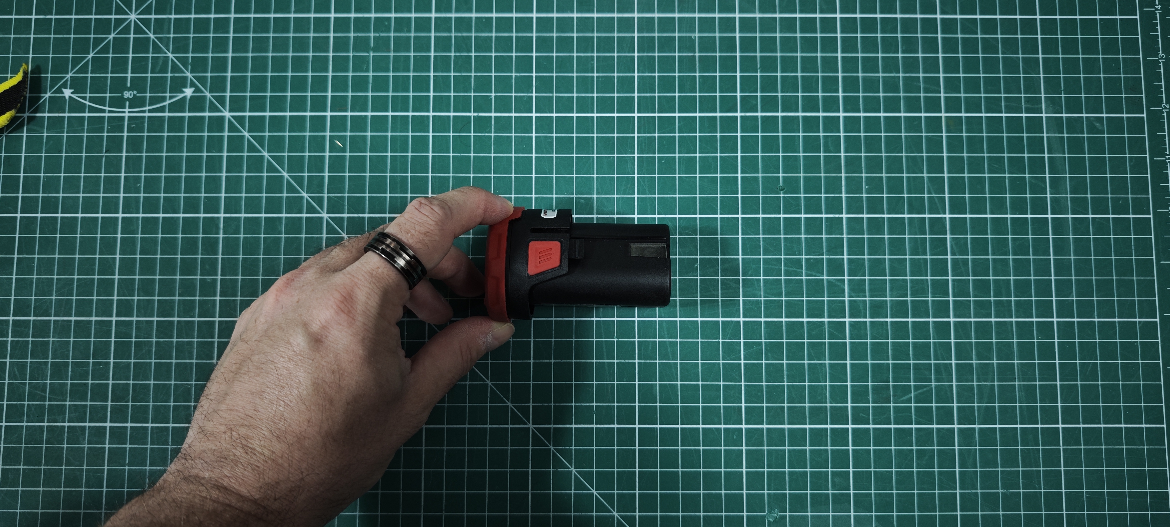
MCAD/electronical-parts/ImagesBatterie/IMG_20250729_205804.jpg
