Barbatronic/CDR-2027/ECAD/main-board-2027/3dmodels/D36V50F5_retourne_assemblage_7mm.step

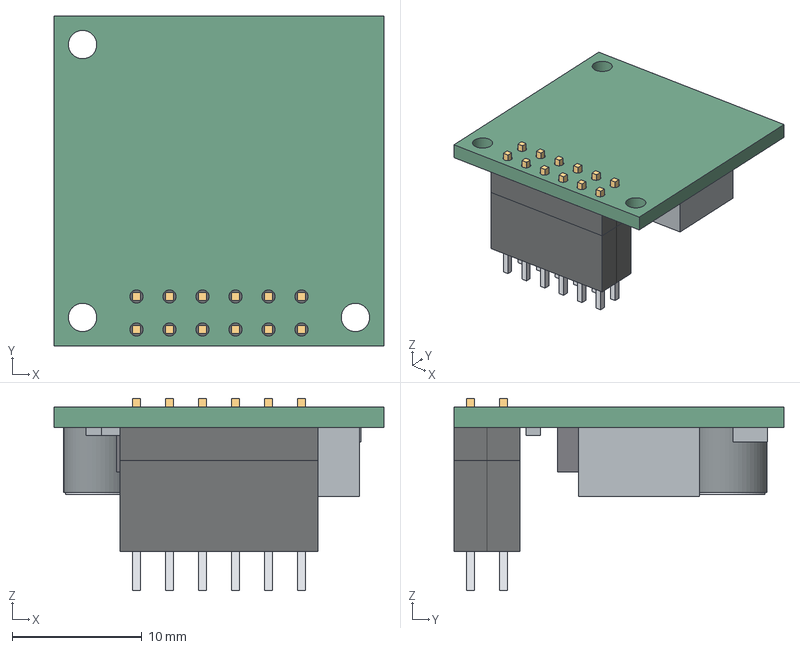
[picture p73: CAD file, 2026-11-09]
ECAD/main-board-2027/3dmodels/D36V50F5_retourne_assemblage_7mm.step
25.4 x 25.4 x 14.8 mm
female_housing_1
male_housing_1
female_housing_2
male_housing_2
female_contact_01
female_solder_tail_01
male_pin_01
female_contact_02
female_solder_tail_02
male_pin_02
female_contact_03
female_solder_tail_03
male_pin_03
female_contact_04
female_solder_tail_04
male_pin_04
female_contact_05
female_solder_tail_05
male_pin_05
female_contact_06
female_solder_tail_06
male_pin_06
female_contact_07
female_solder_tail_07
male_pin_07
female_contact_08
female_solder_tail_08
male_pin_08
female_contact_09
female_solder_tail_09
male_pin_09
female_contact_10
female_solder_tail_10
male_pin_10
female_contact_11
female_solder_tail_11
male_pin_11
female_contact_12
female_solder_tail_12
male_pin_12
Pololu_D36V50F5_PCB_25p4x25p4
plated_hole_ring_1
plated_hole_ring_2
plated_hole_ring_3
plated_hole_ring_4
plated_hole_ring_5
plated_hole_ring_6
plated_hole_ring_7
plated_hole_ring_8
plated_hole_ring_9
plated_hole_ring_10
plated_hole_ring_11
plated_hole_ring_12
power_inductor_envelope
power_ic_envelope
electrolytic_capacitor_1
capacitor_top_1
electrolytic_capacitor_2
capacitor_top_2
smd_component_1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
