Barbatronic/CDR-2027/ECAD/main-board-2027/3dmodels/W5500_B0GFDSVVD8_visuel_approx_assemblage_7mm.step

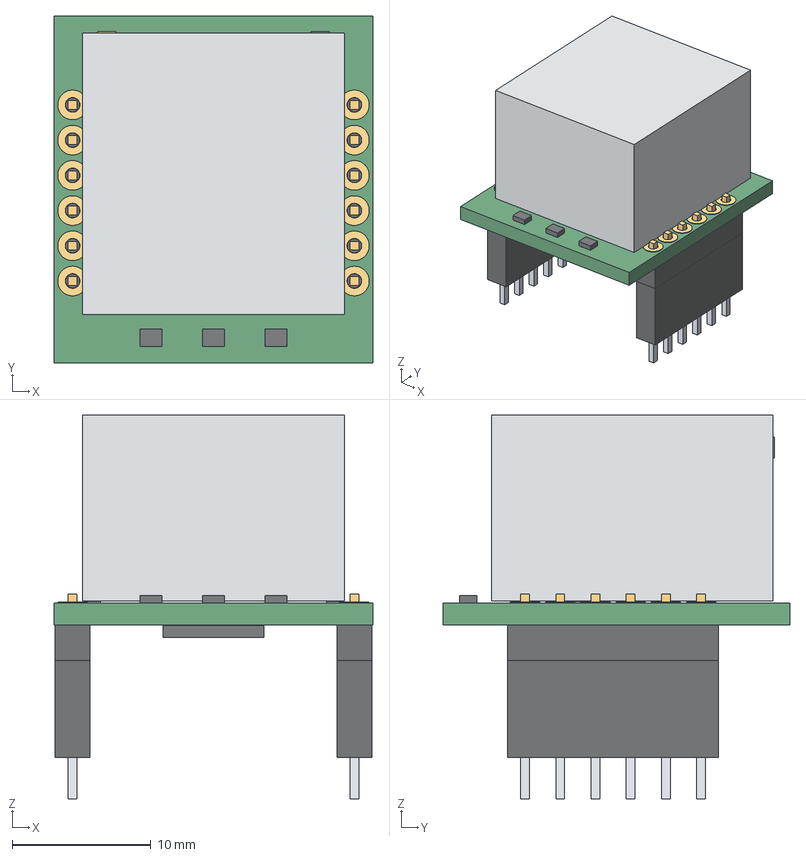
[picture p74: CAD file, 2026-11-09]
ECAD/main-board-2027/3dmodels/W5500_B0GFDSVVD8_visuel_approx_assemblage_7mm.step
23.0 x 25.0 x 27.7 mm
female_housing_1
male_housing_1
female_housing_2
male_housing_2
female_contact_01
female_solder_tail_01
male_pin_01
female_contact_02
female_solder_tail_02
male_pin_02
female_contact_03
female_solder_tail_03
male_pin_03
female_contact_04
female_solder_tail_04
male_pin_04
female_contact_05
female_solder_tail_05
male_pin_05
female_contact_06
female_solder_tail_06
male_pin_06
female_contact_07
female_solder_tail_07
male_pin_07
female_contact_08
female_solder_tail_08
male_pin_08
female_contact_09
female_solder_tail_09
male_pin_09
female_contact_10
female_solder_tail_10
male_pin_10
female_contact_11
female_solder_tail_11
male_pin_11
female_contact_12
female_solder_tail_12
male_pin_12
pcb_W5500_23x25_approx
pad_plated_1
pad_plated_2
pad_plated_3
pad_plated_4
pad_plated_5
pad_plated_6
pad_plated_7
pad_plated_8
pad_plated_9
pad_plated_10
pad_plated_11
pad_plated_12
RJ45_metal_shield
RJ45_black_inner
RJ45_contact_1
RJ45_contact_2
RJ45_contact_3
RJ45_contact_4
RJ45_contact_5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
