Barbatronic/CDR-2027/MCAD/electronical-parts/MainBoardSupport.FCStd

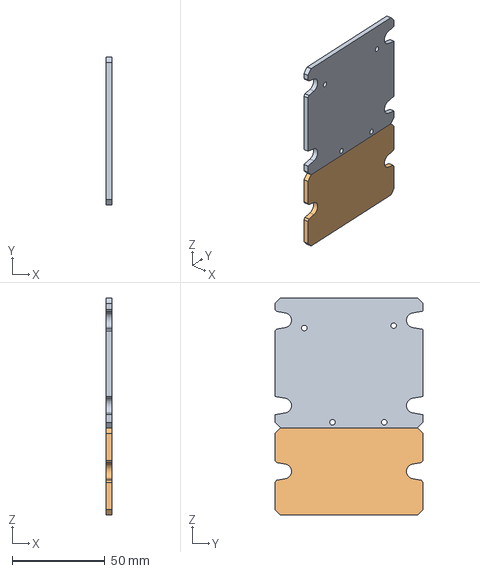
[picture p75: CAD file, 2026-08-17]
MCAD/electronical-parts/MainBoardSupport.FCStd
3.00 x 80.0 x 117.0 mm
CarterElecESP32-UNO
ProlongationCarterUno
