Barbatronic/CDR-2027/ECAD/main-board-2027/3dmodels/Molex_KK-396_A-41791-0002_1x02_P3.96mm_Vertical.step

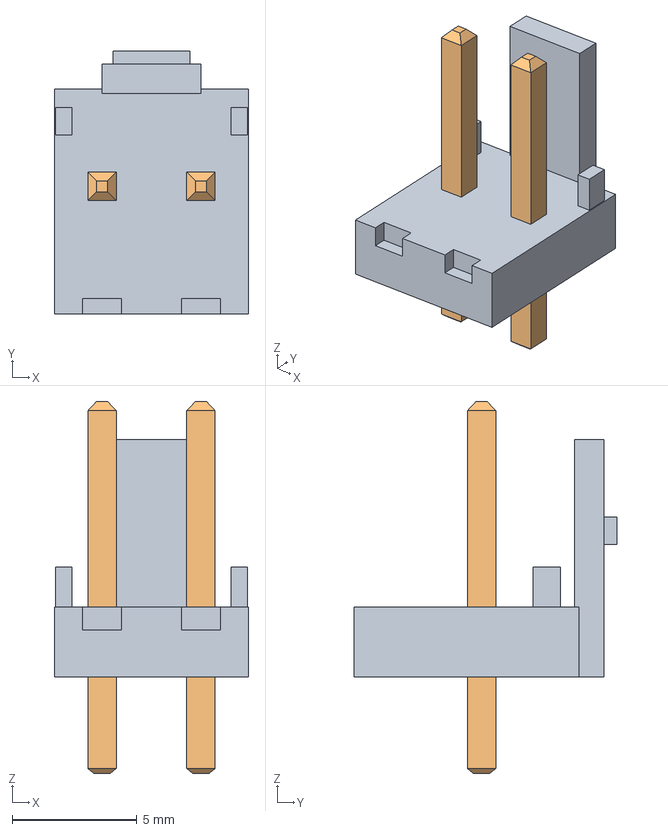
[picture p76: CAD file, 2026-11-09]
ECAD/main-board-2027/3dmodels/Molex_KK-396_A-41791-0002_1x02_P3.96mm_Vertical.step
7.78 x 10.5 x 14.9 mm
