Barbatronic/CDR-2027/MCAD/3d-print/box-manipulator-arm-manipulatorarm.3mf

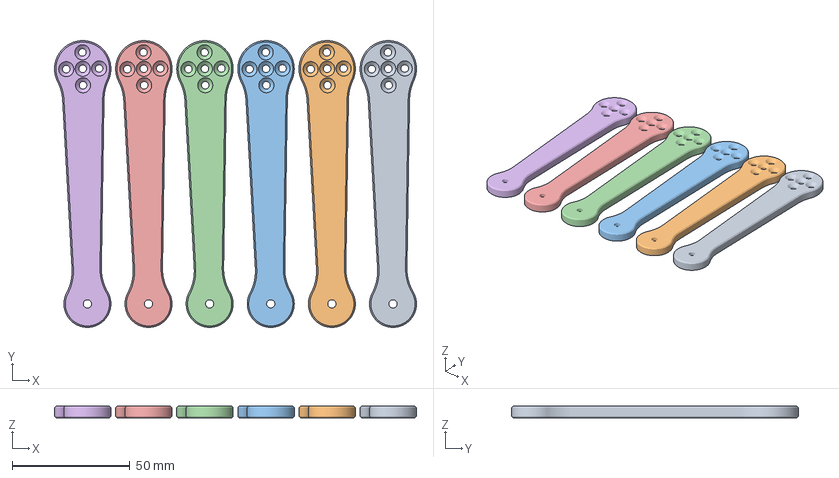
[picture p77: CAD file, 2026-09-28]
MCAD/3d-print/box-manipulator-arm-manipulatorarm.3mf
154.0 x 122.0 x 5.00 mm
arm x 6
