Barbatronic/CDR-2027/MCAD/actuator-parts/gripper-test.FCStd

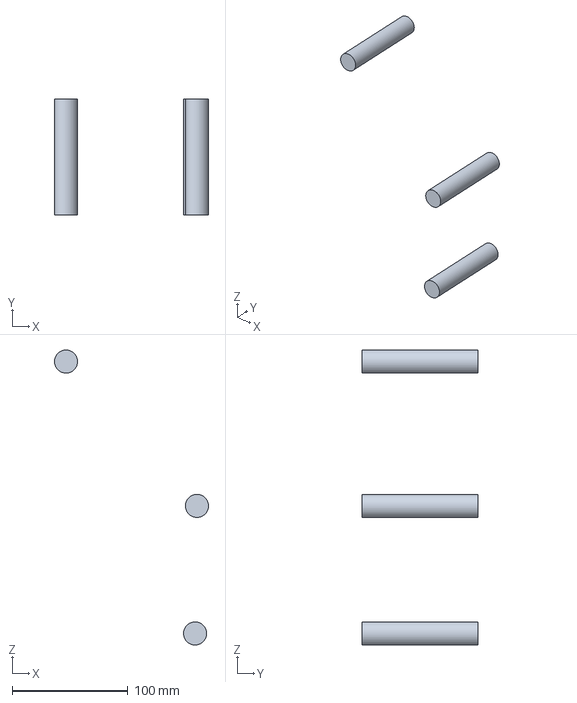
[picture p78: CAD file, 2026-11-04]
MCAD/actuator-parts/gripper-test.FCStd
133.3 x 100.0 x 255.3 mm
