Barbatronic/CDR-2027/MCAD/differential-structure.FCStd

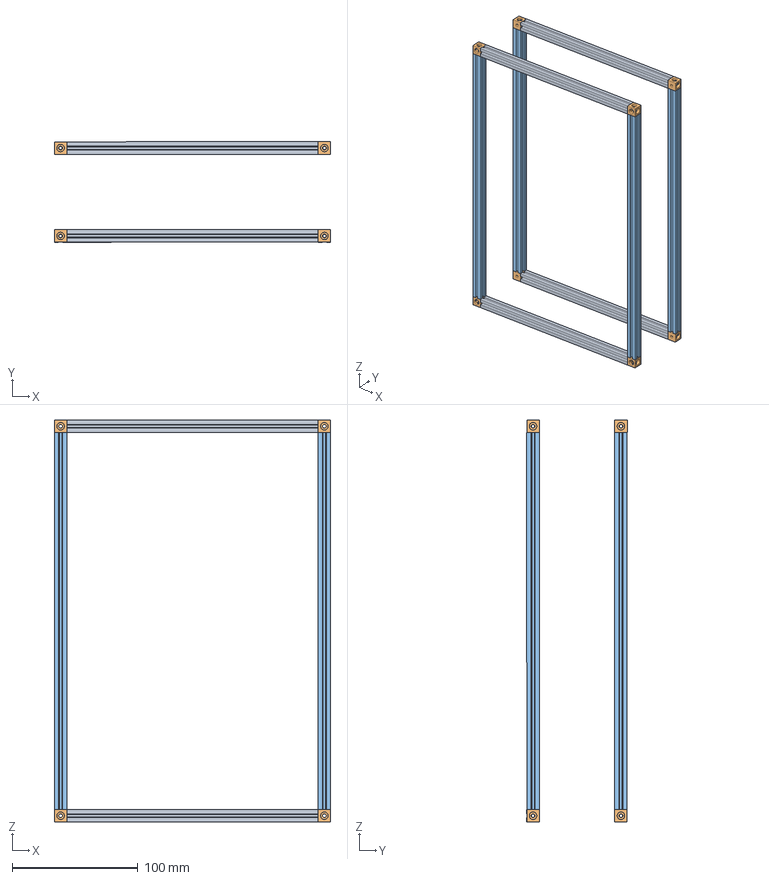
[picture p79: CAD file, 2026-08-17]
MCAD/differential-structure.FCStd
220.0 x 80.0 x 320.0 mm
MB_200 x 4
Corner x 8
MB_300 x 4
