Barbatronic/CDR-2027/MCAD/electronical-parts/SupportBatterie.FCStd

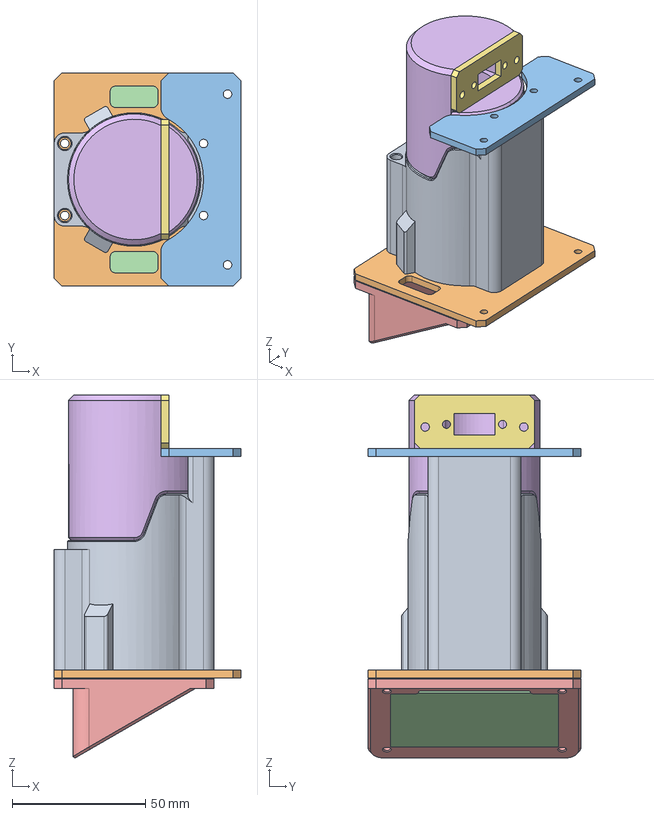
[picture p80: CAD file, 2026-08-17]
MCAD/electronical-parts/SupportBatterie.FCStd
70.0 x 80.0 x 136.1 mm
battery-support
battery-plate
battery-plate001
EcranOled
SupportEcranOled
DummyBattery-Core
PlateXT60
