Barbatronic/CDR-2027/ECAD/main-board-2027/3dmodels/BOB-12009_kit_headers_KiCad10/Headers_femelles_2x_1x06_P2.54.step

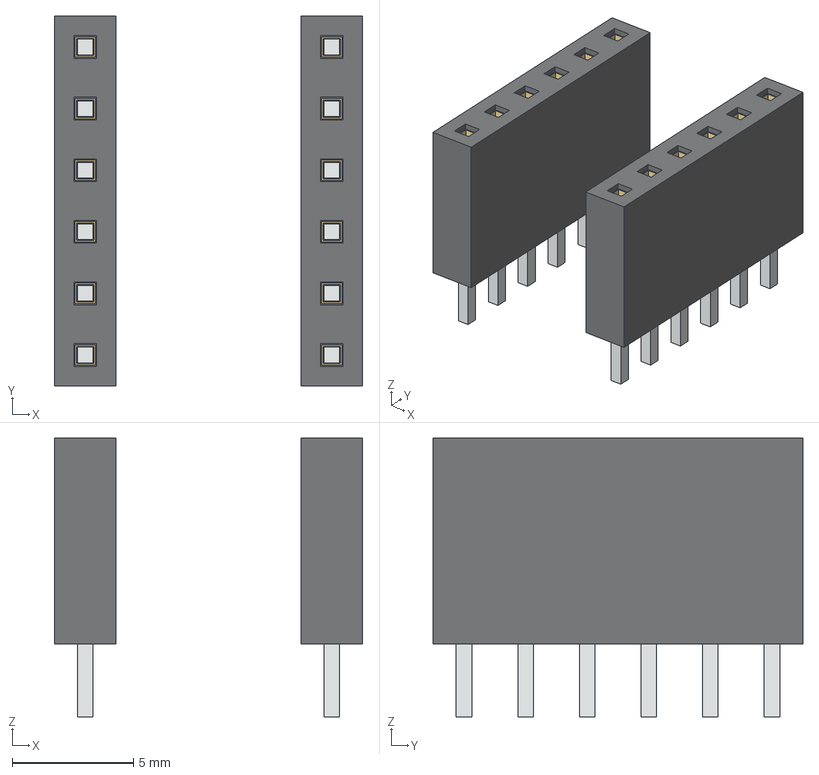
[picture p82: CAD file, 2026-11-09]
ECAD/main-board-2027/3dmodels/BOB-12009_kit_headers_KiCad10/Headers_femelles_2x_1x06_P2.54.step
12.7 x 15.2 x 11.5 mm
female_1x6_housing_1
female_1x6_housing_2
female_contact_1
female_solder_tail_1
female_contact_2
female_solder_tail_2
female_contact_3
female_solder_tail_3
female_contact_4
female_solder_tail_4
female_contact_5
female_solder_tail_5
female_contact_6
female_solder_tail_6
female_contact_7
female_solder_tail_7
female_contact_8
female_solder_tail_8
female_contact_9
female_solder_tail_9
female_contact_10
female_solder_tail_10
female_contact_11
female_solder_tail_11
female_contact_12
female_solder_tail_12
