Barbatronic/CDR-2027/MCAD/actuator-parts/suction-cup-prototype.FCStd

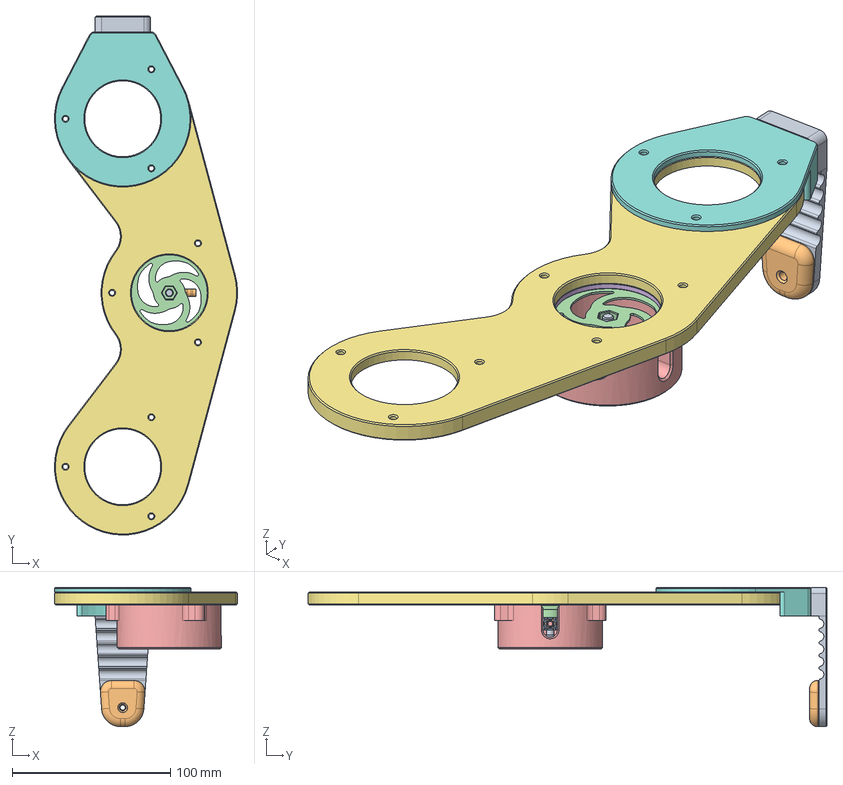
[picture p84: CAD file, 2026-10-28]
MCAD/actuator-parts/suction-cup-prototype.FCStd
115.7 x 328.1 x 88.0 mm
Adaptator-suction-cup-M5-VM
Tube-connector-M5-ID5mm
Rondelle
Corps
Corps001
Corps002
Arm
Corps003
Corps004
Corps005
