Barbatronic/CDR-2027/MCAD/electronical-parts/PCA9685-BoardSupport.FCStd

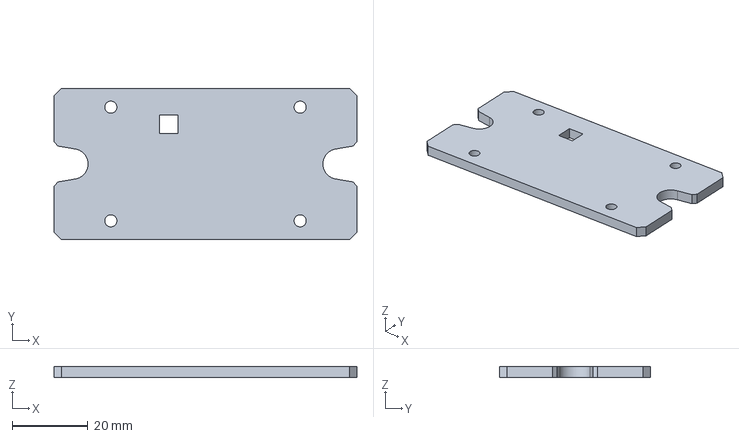
[picture p85: CAD file, 2026-08-17]
MCAD/electronical-parts/PCA9685-BoardSupport.FCStd
80.0 x 40.0 x 3.00 mm
