Barbatronic/CDR-2027/MCAD/mechanical-parts/handle.FCStd

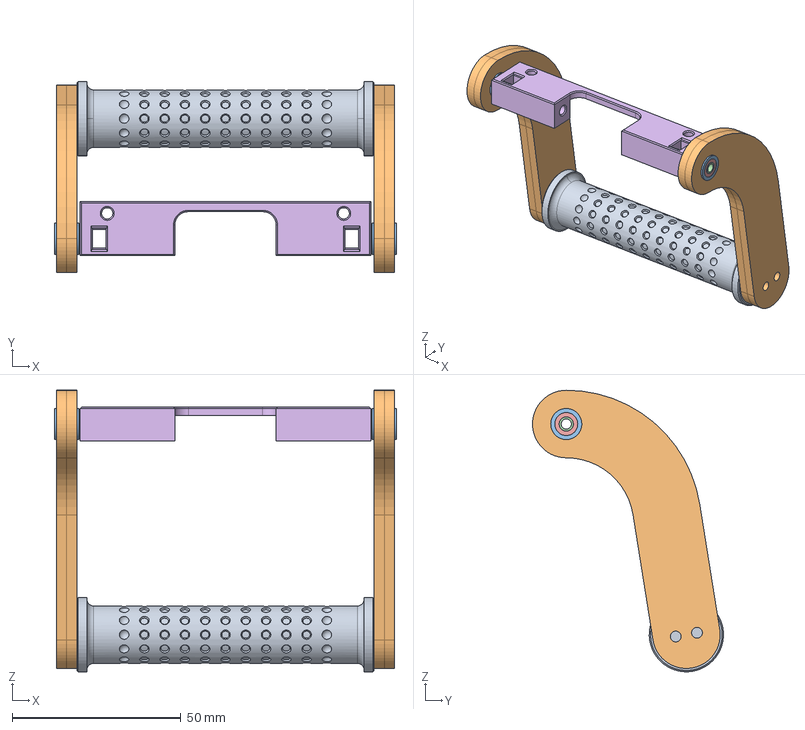
[picture p86: CAD file, 2026-08-17]
MCAD/mechanical-parts/handle.FCStd
101.2 x 56.5 x 83.3 mm
TexturedHandle
LateralPlate x 4
SleeveMF83 x 4
BarreSupportLateral
