Barbatronic/CDR-2027/ECAD/main-board-2027/3dmodels/BOB-12009_kit_headers_KiCad10/BOB-12009_avec_headers_males.step

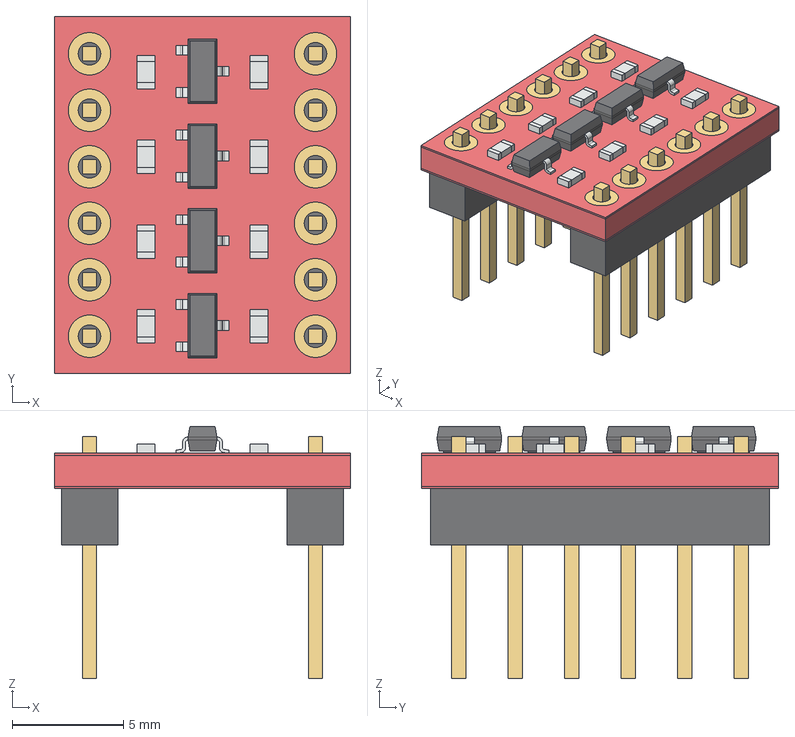
[picture p87: CAD file, 2026-11-09]
ECAD/main-board-2027/3dmodels/BOB-12009_kit_headers_KiCad10/BOB-12009_avec_headers_males.step
13.3 x 16.1 x 11.3 mm
male_1x6_housing_1
male_1x6_housing_2
male_pin_1
male_pin_2
male_pin_3
male_pin_4
male_pin_5
male_pin_6
male_pin_7
male_pin_8
male_pin_9
male_pin_10
male_pin_11
male_pin_12
original_BOB_12009_solid_1
original_BOB_12009_solid_2
original_BOB_12009_solid_3
original_BOB_12009_solid_4
original_BOB_12009_solid_5
original_BOB_12009_solid_6
original_BOB_12009_solid_7
original_BOB_12009_solid_8
original_BOB_12009_solid_9
original_BOB_12009_solid_10
original_BOB_12009_solid_11
original_BOB_12009_solid_12
original_BOB_12009_solid_13
original_BOB_12009_solid_14
original_BOB_12009_solid_15
original_BOB_12009_solid_16
original_BOB_12009_solid_17
original_BOB_12009_solid_18
original_BOB_12009_solid_19
original_BOB_12009_solid_20
original_BOB_12009_solid_21
original_BOB_12009_solid_22
original_BOB_12009_solid_23
original_BOB_12009_solid_24
original_BOB_12009_solid_25
original_BOB_12009_solid_26
original_BOB_12009_solid_27
original_BOB_12009_solid_28
original_BOB_12009_solid_29
original_BOB_12009_solid_30
original_BOB_12009_solid_31
original_BOB_12009_solid_32
original_BOB_12009_solid_33
original_BOB_12009_solid_34
original_BOB_12009_solid_35
original_BOB_12009_solid_36
original_BOB_12009_solid_37
original_BOB_12009_solid_38
original_BOB_12009_solid_39
original_BOB_12009_solid_40
original_BOB_12009_solid_41
original_BOB_12009_solid_42
original_BOB_12009_solid_43
original_BOB_12009_solid_44
original_BOB_12009_solid_45
original_BOB_12009_solid_46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
