Barbatronic/CDR-2027/ECAD/main-board-2027/3dmodels/zeroerr-epower-30-power-connector-xt-u-f-dc-48-v-1-stp.step

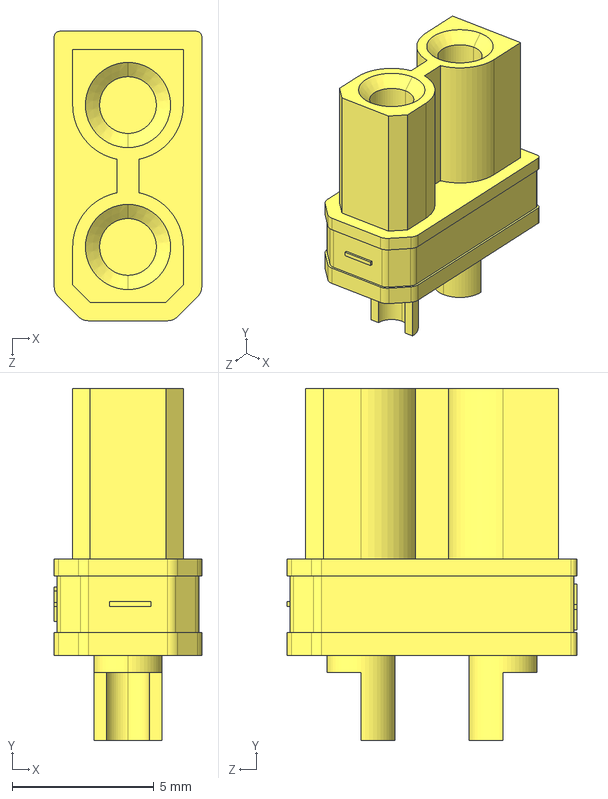
[picture p88: CAD file, 2026-11-09]
ECAD/main-board-2027/3dmodels/zeroerr-epower-30-power-connector-xt-u-f-dc-48-v-1-stp.step
5.20 x 12.4 x 10.2 mm
