Barbatronic/CDR-2027/MCAD/actuator-parts/box-manipulator.FCStd

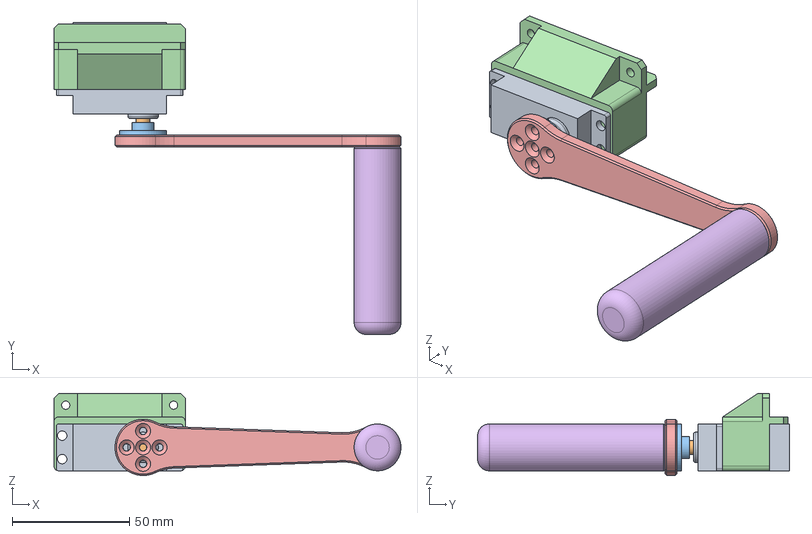
[picture p90: CAD file, 2026-09-28]
MCAD/actuator-parts/box-manipulator.FCStd
148.0 x 133.0 x 35.0 mm
ServoBody
ServoAxis
RoundServoHorn
servo-support
arm
arm-gripper
