Barbatronic/CDR-2027/MCAD/mechanical-parts/molding_parts.FCStd

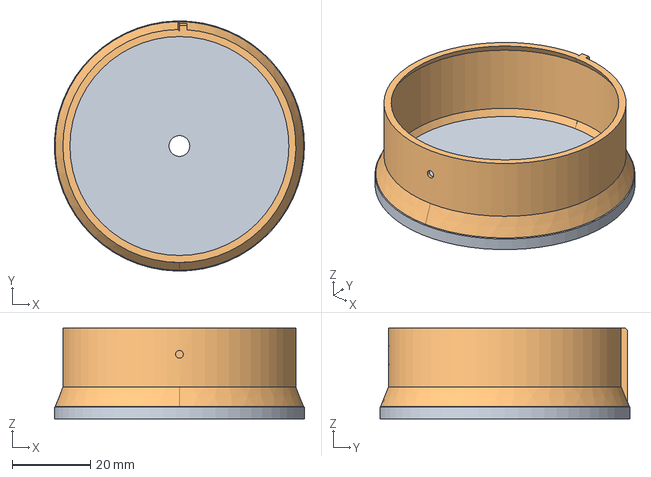
[picture p92: CAD file, 2026-08-17]
MCAD/mechanical-parts/molding_parts.FCStd
64.0 x 64.0 x 23.2 mm
Base_01
