Barbatronic/CDR-2027/ECAD/main-board-2027/3dmodels/BOB-12009_kit_headers_KiCad10/BOB-12009_headers_femelles_7mm.step

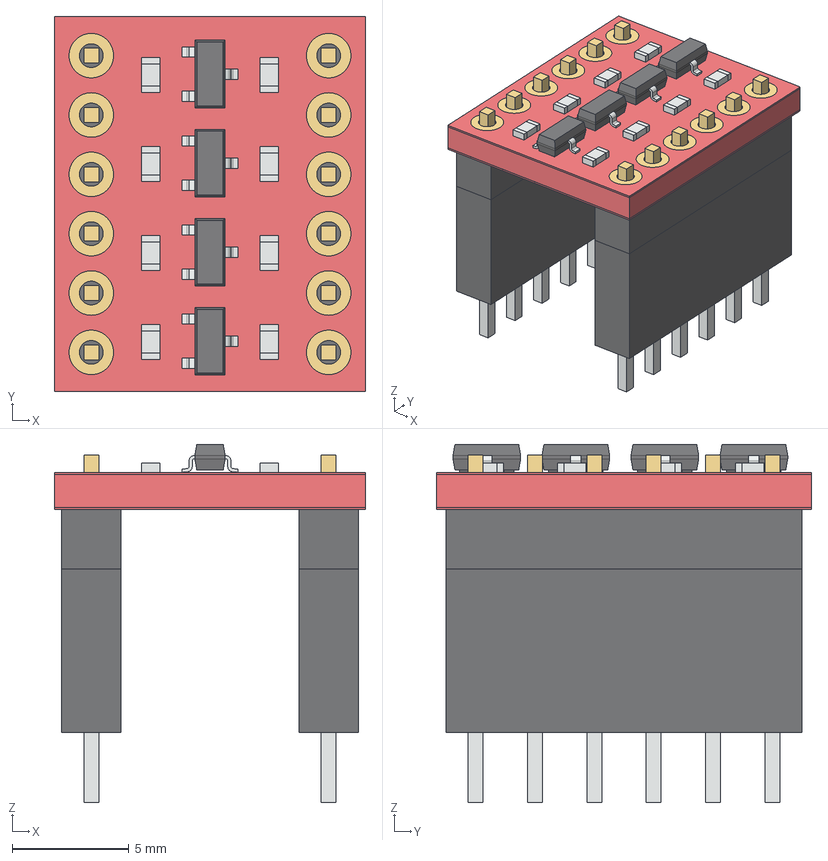
[picture p93: CAD file, 2026-11-09]
ECAD/main-board-2027/3dmodels/BOB-12009_kit_headers_KiCad10/BOB-12009_headers_femelles_7mm.step
13.3 x 16.1 x 15.3 mm
female_1x6_housing_1
female_1x6_housing_2
female_contact_1
female_solder_tail_1
female_contact_2
female_solder_tail_2
female_contact_3
female_solder_tail_3
female_contact_4
female_solder_tail_4
female_contact_5
female_solder_tail_5
female_contact_6
female_solder_tail_6
female_contact_7
female_solder_tail_7
female_contact_8
female_solder_tail_8
female_contact_9
female_solder_tail_9
female_contact_10
female_solder_tail_10
female_contact_11
female_solder_tail_11
female_contact_12
female_solder_tail_12
male_1x6_housing_1
male_1x6_housing_2
male_pin_1
male_pin_2
male_pin_3
male_pin_4
male_pin_5
male_pin_6
male_pin_7
male_pin_8
male_pin_9
male_pin_10
male_pin_11
male_pin_12
original_BOB_12009_solid_1
original_BOB_12009_solid_2
original_BOB_12009_solid_3
original_BOB_12009_solid_4
original_BOB_12009_solid_5
original_BOB_12009_solid_6
original_BOB_12009_solid_7
original_BOB_12009_solid_8
original_BOB_12009_solid_9
original_BOB_12009_solid_10
original_BOB_12009_solid_11
original_BOB_12009_solid_12
original_BOB_12009_solid_13
original_BOB_12009_solid_14
original_BOB_12009_solid_15
original_BOB_12009_solid_16
original_BOB_12009_solid_17
original_BOB_12009_solid_18
original_BOB_12009_solid_19
original_BOB_12009_solid_20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
