Barbatronic/CDR-2027/ECAD/main-board-2027/3dmodels/modele_APEM_A01ES_DM_A0154B_D.step

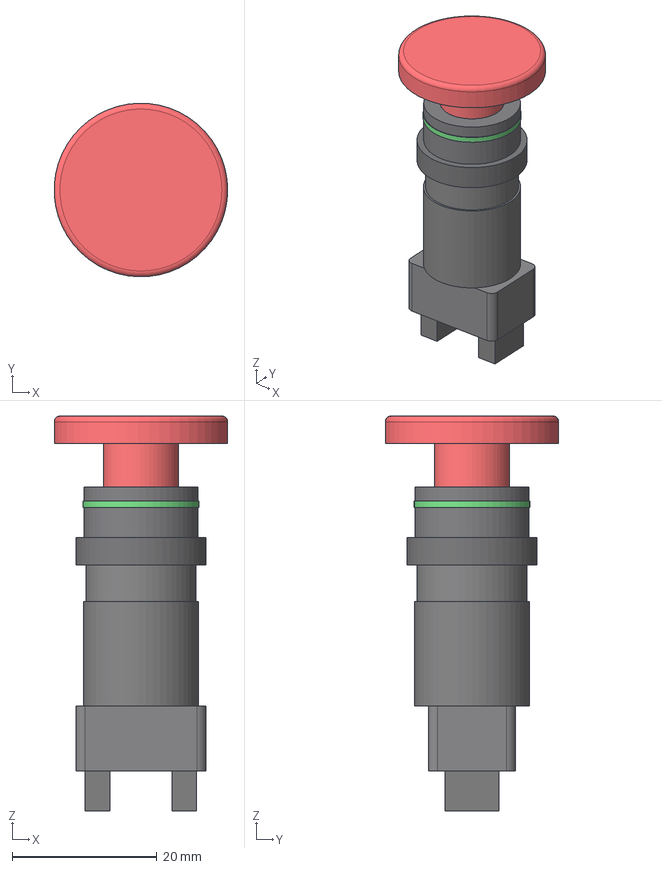
[picture p94: CAD file, 2026-11-09]
ECAD/main-board-2027/3dmodels/modele_APEM_A01ES_DM_A0154B_D.step
24.0 x 24.0 x 54.6 mm
01_Tete_rouge_D24
02_Tige_rouge
03_Haut_corps_noir
04_Collerette_noire_D18
05_Col_traversant_panneau
06_Corps_filete_simplifie
07_Bague_statut_verte
08_Bloc_contacts_2NF_approximatif
09_Jambe_1
10_Cosse_1_indicative
09_Jambe_2
10_Cosse_2_indicative
