Barbatronic/CDR-2027/MCAD/3d-print/Canon5Balles.3mf

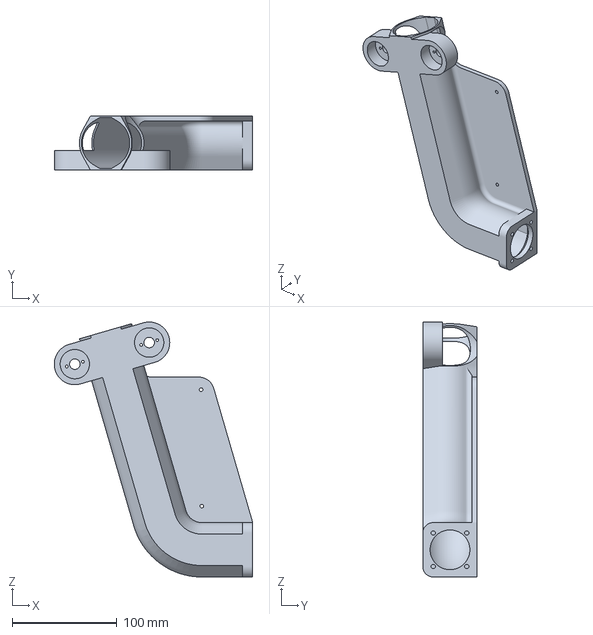
[picture p95: CAD file, 2026-09-27]
MCAD/3d-print/Canon5Balles.3mf
189.6 x 52.0 x 243.6 mm
