Barbatronic/CDR-2027/MCAD/electronical-parts/Battery-test.FCStd

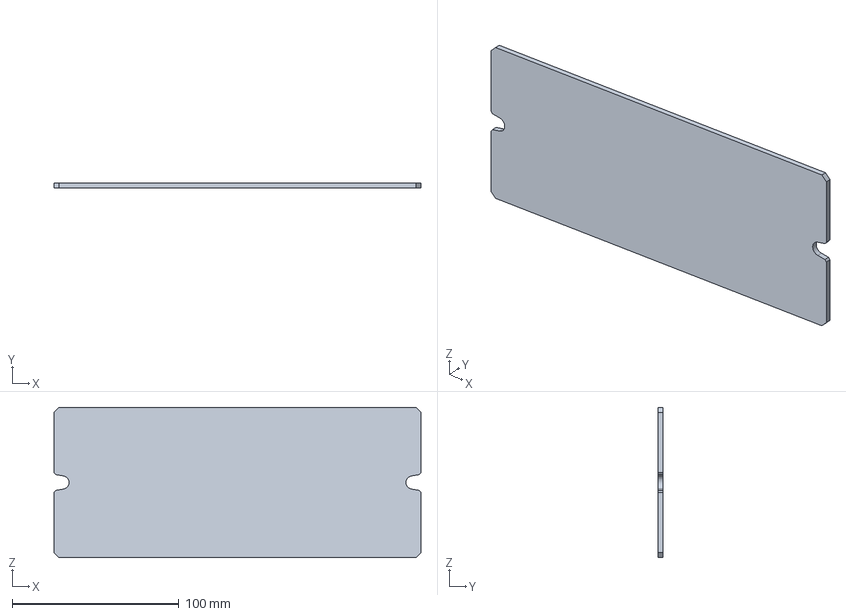
[picture p97: CAD file, 2026-08-17]
MCAD/electronical-parts/Battery-test.FCStd
220.0 x 3.00 x 90.0 mm
