Barbatronic/CDR-2027/MCAD/mechanical-parts/MF83.step

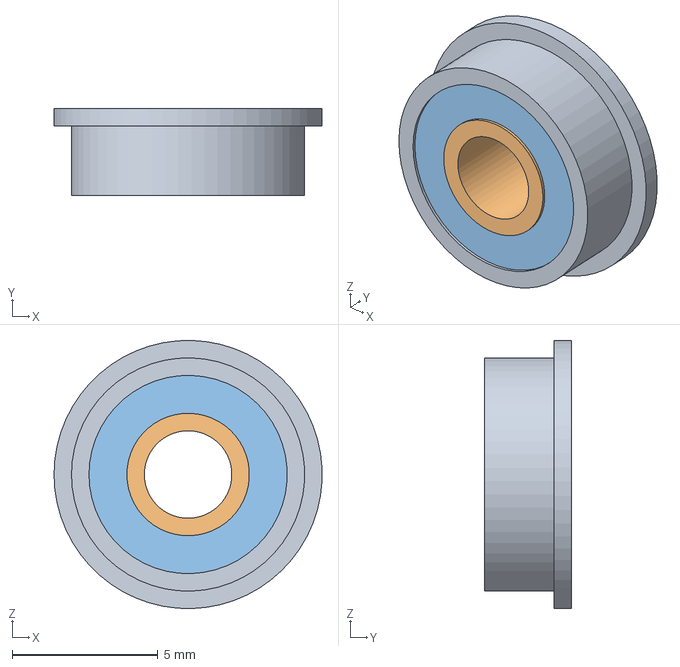
[picture p98: CAD file, 2026-08-17]
MCAD/mechanical-parts/MF83.step
9.19 x 3.00 x 9.20 mm
CoreMF83
SleeveMF83
