Barbatronic/CDR-2027/MCAD/electronical-parts/TopIHM.FCStd

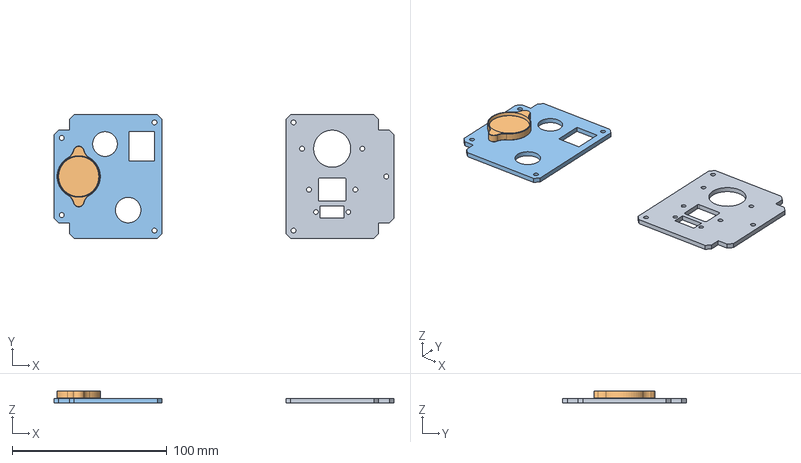
[picture p100: CAD file, 2026-08-17]
MCAD/electronical-parts/TopIHM.FCStd
220.0 x 80.0 x 8.00 mm
CarterScreenUSB
SupportTirette
CarterIHM
