Barbatronic/CDR-2027/MCAD/mechanical-parts/LateralActuator.FCStd

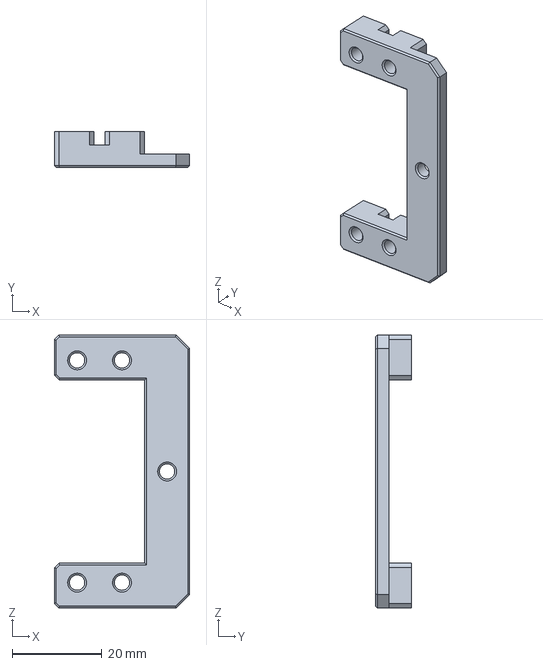
[picture p101: CAD file, 2026-08-17]
MCAD/mechanical-parts/LateralActuator.FCStd
30.1 x 8.00 x 60.8 mm
