Barbatronic/CDR-2027/MCAD/electronical-parts/MatBalise.FCStd

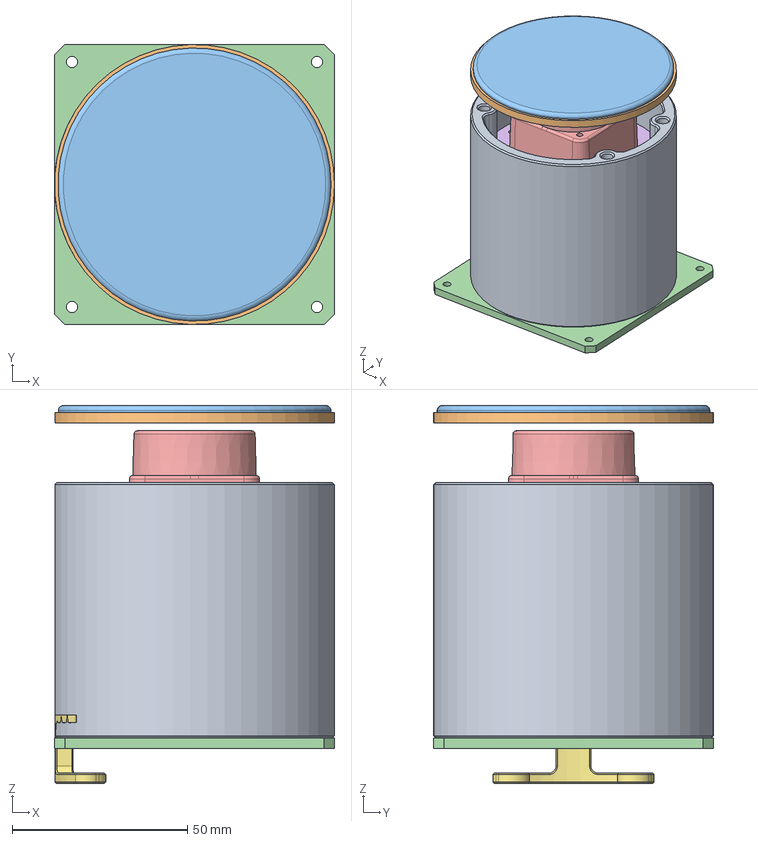
[picture p102: CAD file, 2026-08-17]
MCAD/electronical-parts/MatBalise.FCStd
80.0 x 80.0 x 108.0 mm
Mat
SupportBaliseAdverse
Scratch
CarterMatDeBalise
BaseLD06
SupportInterneLD06
TopSupportSpecial
