Barbatronic/CDR-2027/MCAD/mechanical-parts/elec-top.FCStd

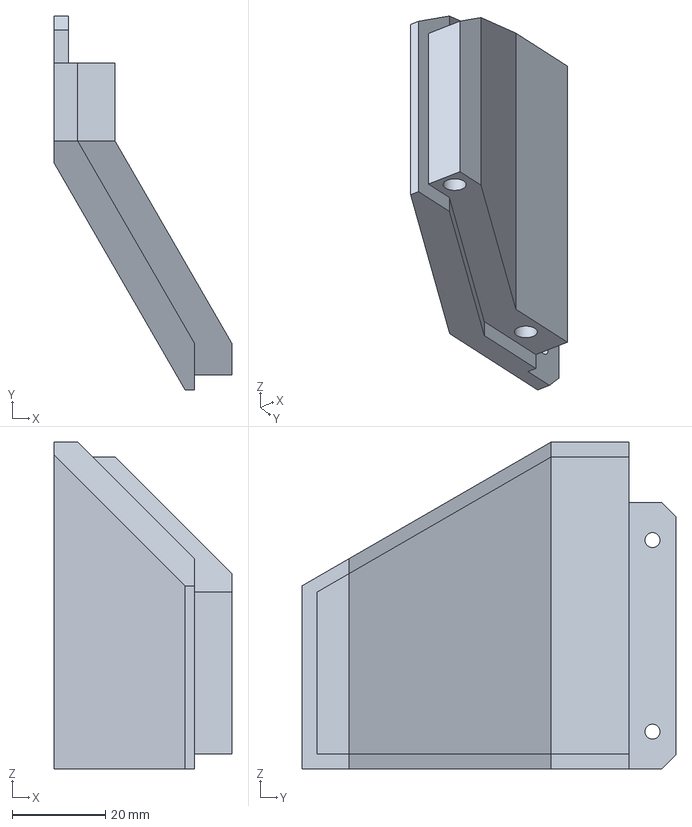
[picture p103: CAD file, 2026-08-17]
MCAD/mechanical-parts/elec-top.FCStd
38.0 x 80.0 x 70.0 mm
