Barbatronic/CDR-2027/MCAD/electronical-parts/GPIOExpanderSupport.FCStd

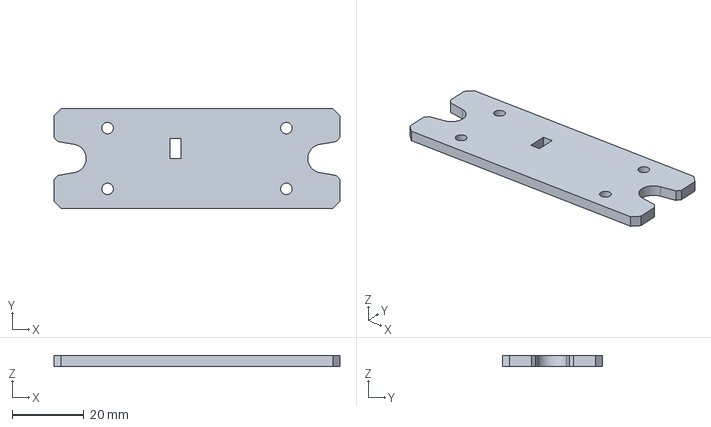
[picture p104: CAD file, 2026-08-17]
MCAD/electronical-parts/GPIOExpanderSupport.FCStd
80.0 x 28.0 x 3.00 mm
