Barbatronic/CDR-2027/MCAD/electronical-parts/DriverBoardSupport.FCStd

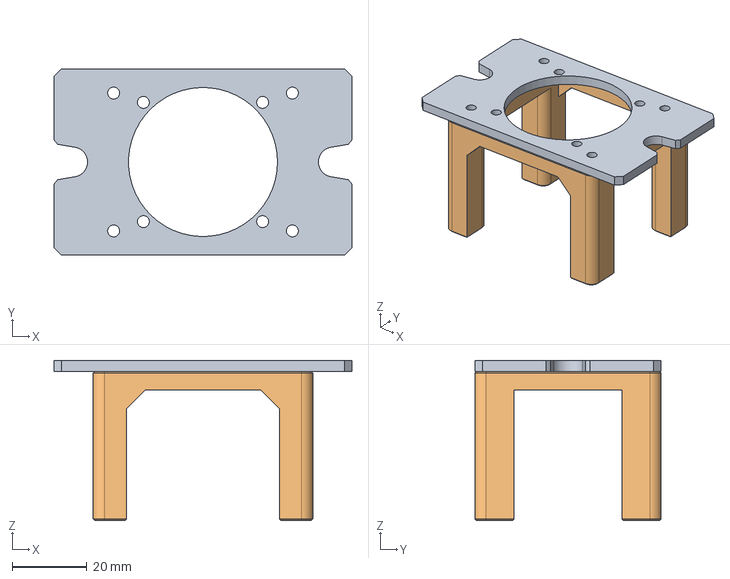
[picture p106: CAD file, 2026-08-17]
MCAD/electronical-parts/DriverBoardSupport.FCStd
80.0 x 50.0 x 43.0 mm
DriverBoardPlate
SupportDriverBoard
