Barbatronic/CDR-2027/(list of files, cad)

Other CAD files:
MCAD/mechanical-parts/generic-hardware.FCStd
