Barbatronic/CDR-2027/ECAD/main-board-2027/main-board-2027.kicad_pcb

## KiCad design ECAD/main-board-2027/main-board-2027.kicad_pcb (2026-11-09)

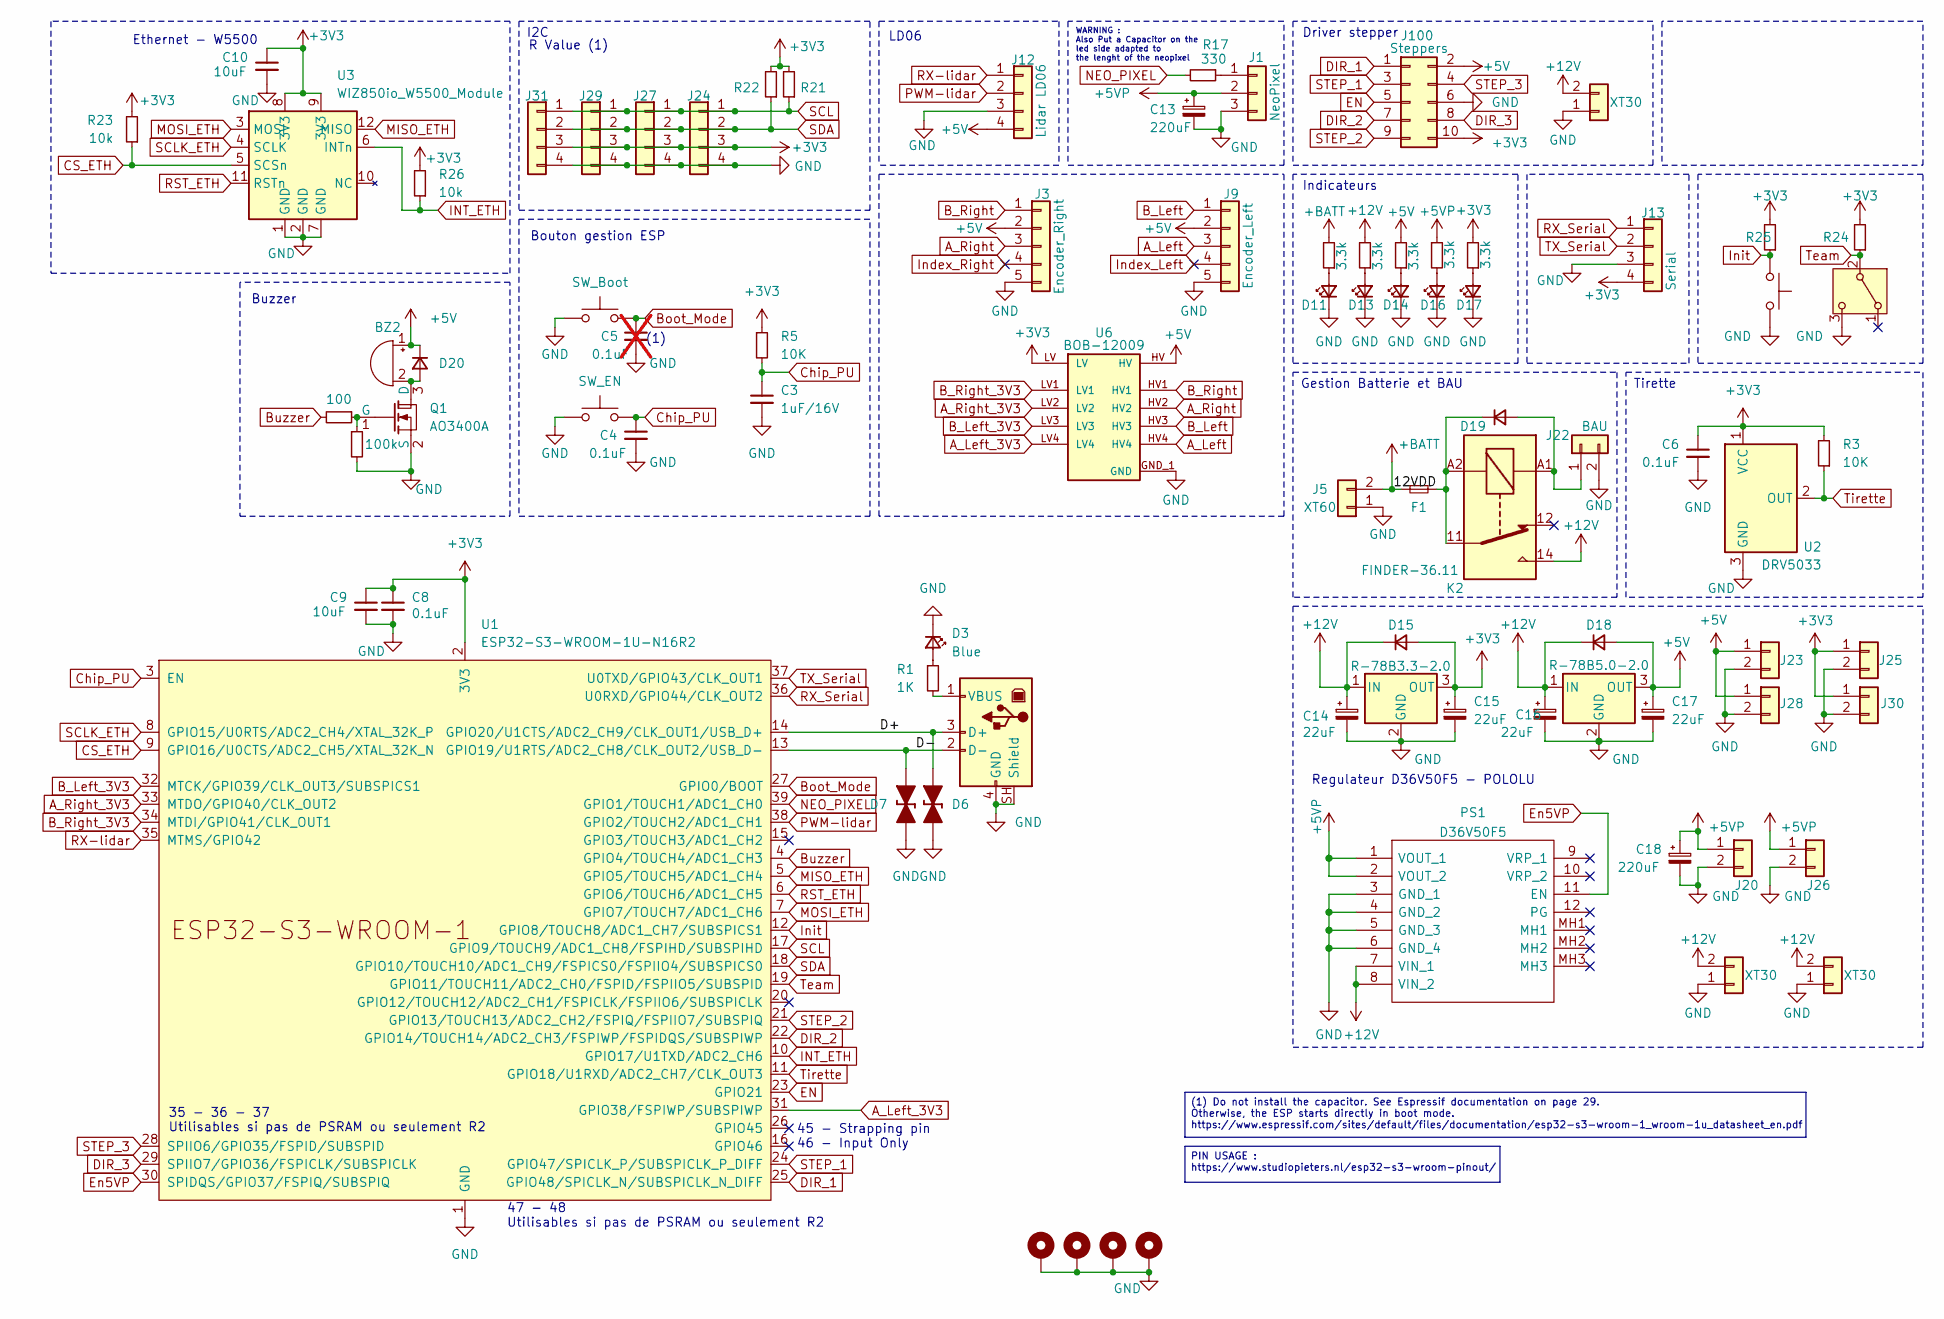
[picture p107: schematic main-board-2027.kicad_sch]

Parts:
BZ2: Buzzer; Buzzer_12x9.5RM7.6
C3: 1uF/16V; C_1206_3216Metric
C4: 0.1uF; C_1206_3216Metric
C5: 0.1uF; C_1206_3216Metric; not fitted
C6, C8: 0.1uF; C_1206_3216Metric_Pad1.33x1.80mm_HandSolder
C9, C10: 10uF; C_1206_3216Metric_Pad1.33x1.80mm_HandSolder
C13, C18: 220uF; CP_Radial_D8.0mm_P3.80mm
C14, C15, C16, C17: 22uF; CP_Elec_5x5.4
D3: Blue; LED_1206_3216Metric
D6, D7: D_TVS_Bidirectional_Generic; D_SOD-523
D11, D13, D14, D16, D17: LED_Small; LED_1206_3216Metric_Pad1.42x1.75mm_HandSolder
D15, D18, D19: D_Small; D_SMA_Handsoldering
D20: SS34; D_SMA_Handsoldering
F1: Fuse_Small; Fuseholder_Blade_Mini_Keystone_3568
H5, H6, H7, H8: MountingHole_Pad; MountingHole_3.2mm_M3_Pad_Via
J1: NeoPixel; Molex_KK-254_AE-6410-03A_1x03_P2.54mm_Vertical
J2: USB_B; USB_B_TE_5787834_Vertical
J3: Encoder_Right; Molex_KK-254_AE-6410-05A_1x05_P2.54mm_Vertical
J5: XT60; AMASS_XT60-M_1x02_P7.20mm_Vertical
J9: Encoder_Left; Molex_KK-254_AE-6410-05A_1x05_P2.54mm_Vertical
J12: Lidar LD06; Molex_KK-254_AE-6410-04A_1x04_P2.54mm_Vertical
J13: Serial; Molex_KK-254_AE-6410-04A_1x04_P2.54mm_Vertical
J16, J17, J18: XT30; AMASS_XT30U-F_1x02_P5.0mm_Vertical
J20, J26: Molex_KK-396_A-41791-0002_1x02_P3.96mm_Vertical
J22: BAU; Molex_KK-396_A-41791-0002_1x02_P3.96mm_Vertical
J23, J25, J28, J30: Conn_01x02; Molex_KK-254_AE-6410-02A_1x02_P2.54mm_Vertical
J24, J27, J29, J31: External tools; Molex_KK-254_AE-6410-04A_1x04_P2.54mm_Vertical
J100: Steppers; IDC-Header_2x05_P2.54mm_Vertical
K2: FINDER-36.11; Relay_SPDT_Finder_36.11
PS1: D36V50F5; Manufacturer_Part_Number D36V50F5
Q1: AO3400A; SOT-23_Handsoldering
R1: 1K; R_1206_3216Metric_Pad1.30x1.75mm_HandSolder
R3, R5: 10K; R_1206_3216Metric_Pad1.30x1.75mm_HandSolder
R15, R16, R18, R19, R20: 3.3k; R_1206_3216Metric_Pad1.30x1.75mm_HandSolder
R17: 330; R_1206_3216Metric_Pad1.30x1.75mm_HandSolder
R21, R22: 4.7k; R_1206_3216Metric_Pad1.30x1.75mm_HandSolder
R23, R24, R25, R26: 10k; R_1206_3216Metric_Pad1.30x1.75mm_HandSolder
R27: 100; R_1206_3216Metric_Pad1.30x1.75mm_HandSolder
R28: 100k; R_1206_3216Metric_Pad1.30x1.75mm_HandSolder
SW1: SW_SPDT; SK-12D10 1P2T
SW2: SW_Push; SW_Cherry_MX_PCB
SWBoot1: SW_Boot; SW_SPST_CK_RS282G05A3
SWEn1: SW_EN; SW_SPST_CK_RS282G05A3
U1: ESP32-S3-WROOM-1U-N16R2; ESP32-S3-WROOM-1U
U2: DRV5033; SOT-23_Handsoldering
U3: WIZ850io_W5500_Module
U6: BOB-12009; CONV_BOB-12009; PARTREV 01
U7: R-78B3.3-2.0; Converter_DCDC_RECOM_R-78B-2.0_THT
U8: R-78B5.0-2.0; Converter_DCDC_RECOM_R-78B-2.0_THT

Connections:
+3V3: C6.1, C8.1, C9.1, C10.1, C15.1, D15.2 (A), J13.4, J24.3, J25.1, J27.3, J29.3, J30.1, J31.3, J100.10, R3.2, R5.1, R20.2, R21.2, R22.2, R23.2, R24.2, R25.2, R26.2, U1.2 (3V3), U2.1 (VCC), U3.8 (3V3), U3.9 (3V3), U6.LV, U7.3 (OUT)
+5V: BZ2.1 (+), C17.1, D18.2 (A), D20.1 (K), J3.2, J9.2, J12.4, J23.1, J28.1, J100.2, R18.2, U6.HV, U8.3 (OUT)
+5VP: C13.1, C18.1, J1.2, J20.1, J26.1, PS1.1 (VOUT_1), PS1.2 (VOUT_2), R19.1
+12V: C14.1, C16.1, D15.1 (K), D18.1 (K), J16.2, J17.2, J18.2, K2.14, PS1.7 (VIN_1), PS1.8 (VIN_2), R16.2, U7.1 (IN), U8.1 (IN)
+BATT: F1.1, J5.2, R15.2
/12VDD: D19.1 (K), F1.2, K2.11, K2.A2
/D+: D6.2 (A), J2.3 (D+), U1.14 (GPIO20/U1CTS/ADC2_CH9/CLK_OUT1/USB_D+)
/D-: D7.2 (A), J2.2 (D-), U1.13 (GPIO19/U1RTS/ADC2_CH8/CLK_OUT2/USB_D-)
A_Left: J9.3, U6.HV4
A_Left_3V3: U1.31 (GPIO38/FSPIWP/SUBSPIWP), U6.LV4
A_Right: J3.3, U6.HV2
A_Right_3V3: U1.33 (MTDO/GPIO40/CLK_OUT2), U6.LV2
B_Left: J9.1, U6.HV3
B_Left_3V3: U1.32 (MTCK/GPIO39/CLK_OUT3/SUBSPICS1), U6.LV3
B_Right: J3.1, U6.HV1
B_Right_3V3: U1.34 (MTDI/GPIO41/CLK_OUT1), U6.LV1
Boot_Mode: C5.1, SWBoot1.2, U1.27 (GPIO0/BOOT)
Buzzer: R27.2, U1.4 (GPIO4/TOUCH4/ADC1_CH3)
CS_ETH: R23.1, U1.9 (GPIO16/U0CTS/ADC2_CH5/XTAL_32K_N), U3.5 (SCSn)
Chip_PU: C3.1, C4.1, R5.2, SWEn1.2, U1.3 (EN)
DIR_1: J100.1, U1.25 (GPIO48/SPICLK_N/SUBSPICLK_N_DIFF)
DIR_2: J100.7, U1.22 (GPIO14/TOUCH14/ADC2_CH3/FSPIWP/FSPIDQS/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)
DIR_3: J100.8, U1.29 (SPIIO7/GPIO36/FSPICLK/SUBSPICLK)
EN: J100.5, U1.23 (GPIO21)
En5VP: PS1.11 (EN), U1.30 (SPIDQS/GPIO37/FSPIQ/SUBSPIQ)
GND: C3.2, C4.2, C5.2, C6.2, C8.2, C9.2, C10.2, C13.2, C14.2, C15.2, C16.2, C17.2, C18.2, D3.1 (K), D6.1 (K), D7.1 (K), D11.1 (K), D13.1 (K), D14.1 (K), D16.1 (K), D17.1 (K), H5.1 (1_1), H6.1 (1_1), H7.1 (1_1), H8.1 (1_1), J1.3, J2.4 (GND), J2.SH (Shield), J3.5, J5.1, J9.5, J12.3, J13.3, J16.1, J17.1, J18.1, J20.2, J22.2, J23.2, J24.4, J25.2, J26.2, J27.4, J28.2, J29.4, J30.2, J31.4, J100.6, PS1.3 (GND_1), PS1.4 (GND_2), PS1.5 (GND_3), PS1.6 (GND_4), Q1.2 (S), R28.2, SW1.3 (C), SW2.2, SWBoot1.1, SWEn1.1, U1.1 (GND), U1.40 (GND), U1.41 (GND), U2.3 (GND), U3.1 (GND), U3.2 (GND), U3.7 (GND), U6.GND_1 (GND), U6.GND_2 (GND), U7.2 (GND), U8.2 (GND)
INT_ETH: R26.1, U1.10 (GPIO17/U1TXD/ADC2_CH6), U3.6 (INTn)
Index_Left: J9.4
Index_Right: J3.4
Init: R25.1, SW2.1, U1.12 (GPIO8/TOUCH8/ADC1_CH7/SUBSPICS1)
MISO_ETH: U1.5 (GPIO5/TOUCH5/ADC1_CH4), U3.12 (MISO)
MOSI_ETH: U1.7 (GPIO7/TOUCH7/ADC1_CH6), U3.3 (MOSI)
NEO_PIXEL: R17.2, U1.39 (GPIO1/TOUCH1/ADC1_CH0)
unnamed: BZ2.2 (-), D20.2 (A), Q1.3 (D)
unnamed: D3.2 (A), R1.1
unnamed: D11.2 (A), R15.1
unnamed: D13.2 (A), R16.1
unnamed: D14.2 (A), R18.1
unnamed: D16.2 (A), R19.2
unnamed: D17.2 (A), R20.1
unnamed: D19.2 (A), J22.1, K2.A1
unnamed: J1.1, R17.1
unnamed: J2.1 (VBUS), R1.2
unnamed: Q1.1 (G), R27.1, R28.1
PWM-lidar: J12.2, U1.38 (GPIO2/TOUCH2/ADC1_CH1)
RST_ETH: U1.6 (GPIO6/TOUCH6/ADC1_CH5), U3.11 (RSTn)
RX-lidar: J12.1, U1.35 (MTMS/GPIO42)
RX_Serial: J13.1, U1.36 (U0RXD/GPIO44/CLK_OUT2)
SCL: J24.1, J27.1, J29.1, J31.1, R21.1, U1.17 (GPIO9/TOUCH9/ADC1_CH8/FSPIHD/SUBSPIHD)
SCLK_ETH: U1.8 (GPIO15/U0RTS/ADC2_CH4/XTAL_32K_P), U3.4 (SCLK)
SDA: J24.2, J27.2, J29.2, J31.2, R22.1, U1.18 (GPIO10/TOUCH10/ADC1_CH9/FSPICS0/FSPIIO4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)
STEP_1: J100.3, U1.24 (GPIO47/SPICLK_P/SUBSPICLK_P_DIFF)
STEP_2: J100.9, U1.21 (GPIO13/TOUCH13/ADC2_CH2/FSPIQ/FSPIIO7/S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)
STEP_3: J100.4, U1.28 (SPIIO6/GPIO35/FSPID/SUBSPID)
TX_Serial: J13.2, U1.37 (U0TXD/GPIO43/CLK_OUT1)
Team: R24.1, SW1.2 (B), U1.19 (GPIO11/TOUCH11/ADC2_CH0/FSPID/FSPIIO5/S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)
Tirette: R3.1, U1.11 (GPIO18/U1RXD/ADC2_CH7/CLK_OUT3), U2.2 (OUT)

Notes on the sheet:
WARNING : Also Put a Capacitor on the led side adapted to the lenght of the neopixel
R Value (1)
Buzzer
I2C
Gestion Batterie et BAU
Ethernet - W5500
35 - 36 - 37 Utilisables si pas de PSRAM ou seulement R2
Bouton gestion ESP
Tirette
(1)
LD06
47 - 48 Utilisables si pas de PSRAM ou seulement R2
Indicateurs
45 - Strapping pin 46 - Input Only
Regulateur D36V50F5 - POLOLU
Driver stepper
PIN USAGE : https://www.studiopieters.nl/esp32-s3-wroom-pinout/
(1) Do not install the capacitor. See Espressif documentation on page 29. Otherwise, the ESP starts directly in boot mode. https://www.espressif.com/sites/default/files/documentation/esp32-s3-wroom-1_wroom-1u_datasheet_en.pdf

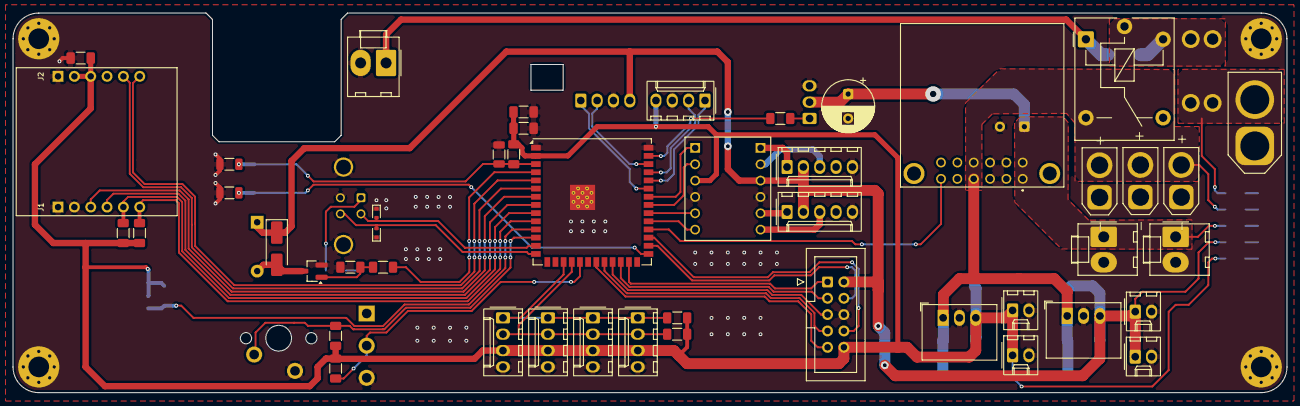
[picture p108: board main-board-2027.kicad_pcb from above]

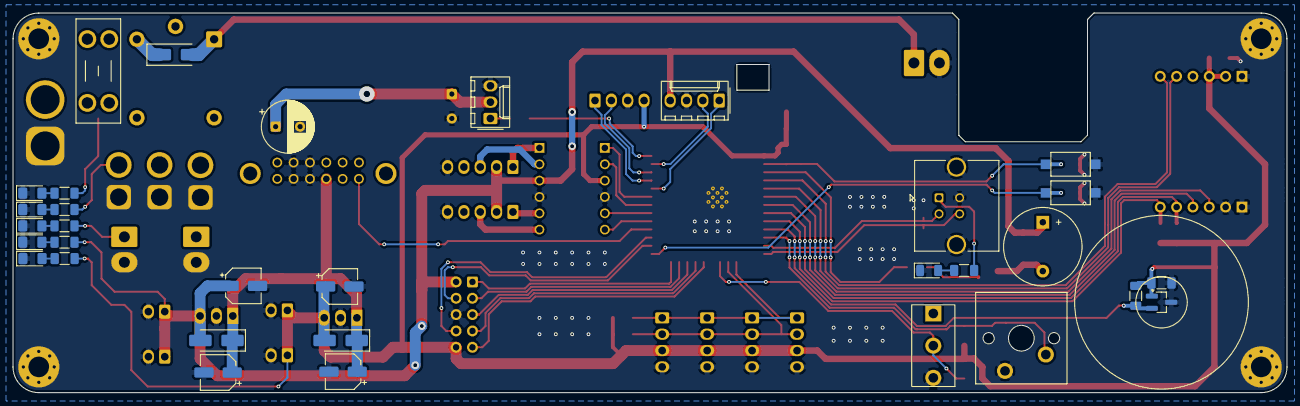
[picture p109: board main-board-2027.kicad_pcb from below]

Board: 2 copper layers, 198.0 x 59.0 mm, 83 parts (32 on the bottom side), 55 nets.
