Barbatronic/CDR-2027/ECAD/I2C-motors-drivers/I2C-motors-drivers.kicad_pcb

## KiCad design ECAD/I2C-motors-drivers/I2C-motors-drivers.kicad_pcb (2026-11-04)

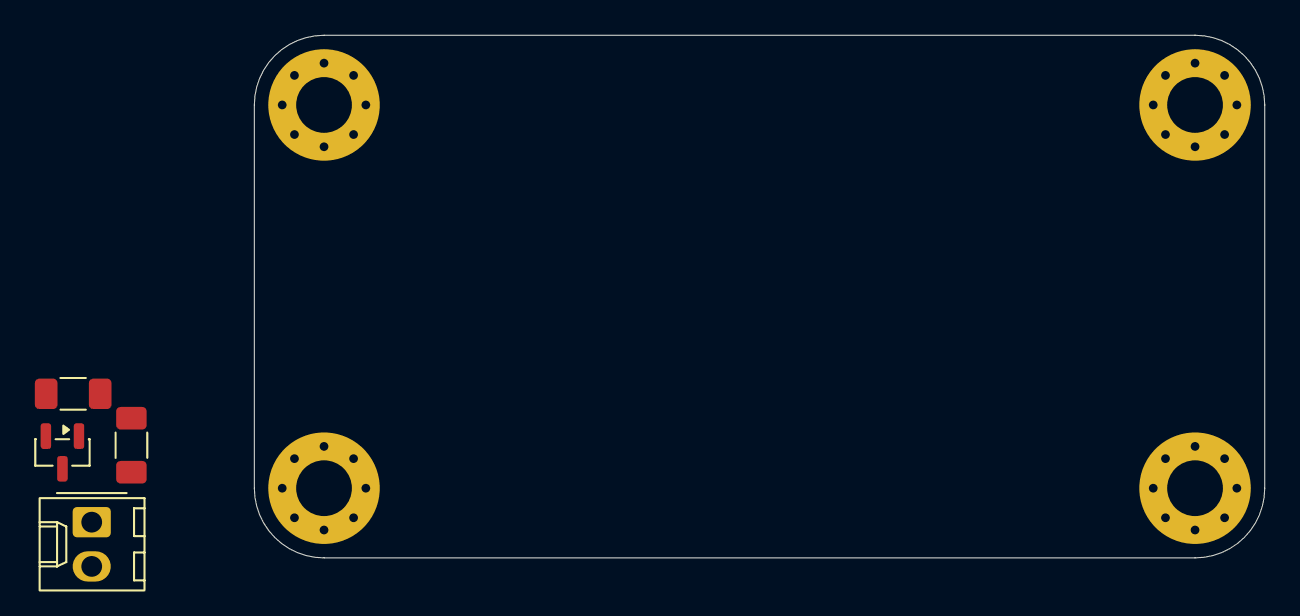
[picture p110: board I2C-motors-drivers.kicad_pcb from above]

Board: 2 copper layers, 58.0 x 30.0 mm, 9 parts (1 on the bottom side), 4 nets, no tracks yet.

Parts:
D4: D_Small; D_SMA_Handsoldering
H1, H2, H3, H4: MountingHole_Pad_MP; MountingHole_3.2mm_M3_Pad_Via
J3: CON_EV; Molex_KK-254_AE-6410-02A_1x02_P2.54mm_Vertical
Q1: AO3400A; SOT-23
R5: 270R; R_1206_3216Metric_Pad1.30x1.75mm_HandSolder
R7: 10K; R_1206_3216Metric_Pad1.30x1.75mm_HandSolder

Connections:
12V: D4.1 (K), J3.2
GND: Q1.2 (S), R7.2
unnamed: D4.2 (A), J3.1, Q1.3 (D)
unnamed: Q1.1 (G), R5.1, R7.1
