Barbatronic/CDR-2027/ECAD/motor-driver/motor-driver.kicad_pcb

## KiCad design ECAD/motor-driver/motor-driver.kicad_pcb (2026-11-04)

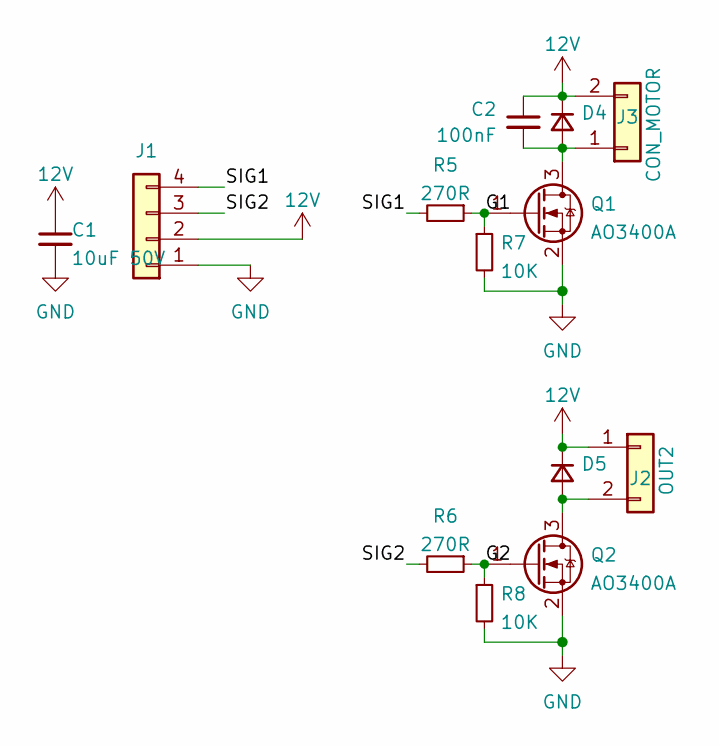
[picture p111: schematic motor-driver.kicad_sch]

Parts:
C1: 10uF 50V; C_1206_3216Metric; LCSC C13585
C2: 100nF; C_1206_3216Metric; LCSC C24497
D4, D5: SS34; D_SMA; LCSC C8678
J1: Conn_01x04; Molex_KK-254_AE-6410-04A_1x04_P2.54mm_Vertical
J2: OUT2; Molex_KK-254_AE-6410-02A_1x02_P2.54mm_Vertical
J3: CON_MOTOR; Moteur_Cosses_2xFente_3.6x2.2mm_R10.6mm
Q1, Q2: AO3400A; SOT-23; LCSC C20917
R5, R6: 270R; R_1206_3216Metric; LCSC C4466
R7, R8: 10K; R_1206_3216Metric; LCSC C17902

Connections:
12V: C1.1, C2.1, D4.1 (K), D5.1 (K), J1.2, J2.1, J3.2
/G1: Q1.1 (G), R5.1, R7.1
/G2: Q2.1 (G), R6.1, R8.1
/SIG1: J1.4, R5.2
/SIG2: J1.3, R6.2
GND: C1.2, J1.1, Q1.2 (S), Q2.2 (S), R7.2, R8.2
unnamed: C2.2, D4.2 (A), J3.1, Q1.3 (D)
unnamed: D5.2 (A), J2.2, Q2.3 (D)

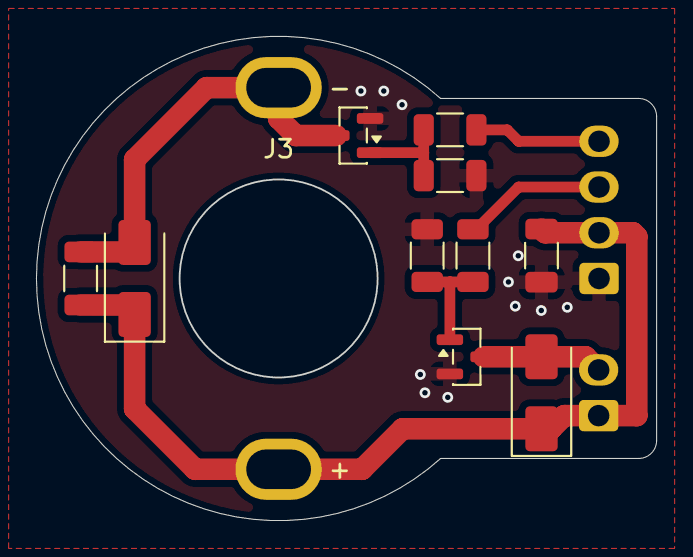
[picture p112: board motor-driver.kicad_pcb from above]

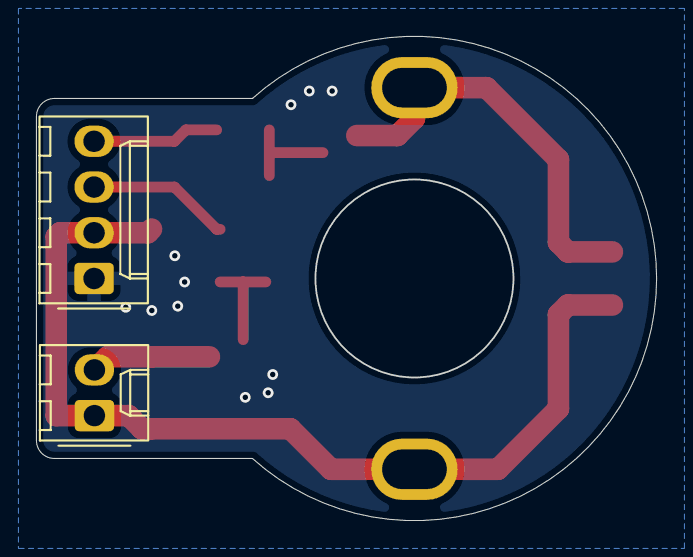
[picture p113: board motor-driver.kicad_pcb from below]

Board: 2 copper layers, 34.5 x 26.9 mm, 13 parts (2 on the bottom side), 8 nets.
