Barbatronic/CDR-2027/FRW/Differential-Robot-Firmware/src/config.h

#pragma once
#include <stdint.h>
#define WIFI_LOG_ENABLED    1
#define WIFI_USE_STA        1
#define LOG_LEVEL  3
#define LIDAR_RX_PIN        9
#define LIDAR_BAUD          230400
#define LIDAR_PWM_PIN       8
#define LIDAR_PWM_FREQ_HZ   10000
#define LIDAR_PWM_DUTY      192       // 75% sur 8 bits → ~3600 RPM
#define LIDAR_OFFSET_DEG    0.0f      // décalage fin (à calibrer) — la correction CW + 90° est dans le code
#define ENC_LEFT_A_PIN      6
#define ENC_LEFT_B_PIN      7
#define ENC_RIGHT_A_PIN     1
#define ENC_RIGHT_B_PIN     2
#define ENC_PPR             2048
#define ENC_COUNTS_PER_REV  (ENC_PPR * 4)
#define ENC_WHEEL_DIAM_MM   50.5821f // diamètre MOYEN des deux roues codeuses (ligne droite, 7/11/2026)
#define ENC_WHEEL_RATIO     1.0f    // diamètre droit / diamètre gauche (carré, lot 2)
#define ENC_WHEELBASE_MM    187.727f // entre roues codeuses (tours sur place, 7/11/2026 ;
#define MM_PER_COUNT        (3.14159265f * ENC_WHEEL_DIAM_MM / ENC_COUNTS_PER_REV)
#define ENC_LEFT_INVERT     false   // inverser sens encodeur gauche
#define ENC_RIGHT_INVERT    true    // inverser sens encodeur droit
#define STEPPER_R_STEP_PIN  12
#define STEPPER_R_DIR_PIN   13
#define STEPPER_L_STEP_PIN  11
#define STEPPER_L_DIR_PIN   10
#define STEPPER_EN_PIN      21          // LOW = activé (commun aux deux)
#define STEPPER_L_INVERT    false        // inverser sens logique moteur gauche
#define STEPPER_R_INVERT    true       // inverser sens logique moteur droit
#define STEPPER_STEPS_REV   1600      // 200 pas × 8 micropas
#define DRIVE_WHEEL_DIAM_MM 57.53f
#define STEPS_PER_MM        ((float)STEPPER_STEPS_REV / (3.14159265f * DRIVE_WHEEL_DIAM_MM))
#define WHEELBASE_MM            146.07f  // entre roues motrices (tours sur place, 7/11/2026)
#define ROBOT_BACK_TO_CENTER_MM   134.82f  // arrière du robot → axe des roues
#define ROBOT_FRONT_TO_CENTER_MM   80.9f   // avant du robot (bras ouverts) → axe des roues
#define ROBOT_WIDTH_MM            232.0f   // largeur hors tout (cible cliquée bornée à ± la moitié)
#define CALAGE_STALL_MM         250.0f  // course max du recul jusqu'au contact bordure
#define CALAGE_X_MM             375.0f  // centre robot ↔ bordure latérale après dégagement
#define CALAGE_Y_MM             360.0f  // centre robot ↔ bordure du fond après dégagement
#define PIERRE_EPAISSEUR_MM     110.0f  // profondeur d'une carrière (pierre couchée 320×110×110)
#define CARRIERE_APPROCHE_MM    100.0f  // décalage avant ↔ face de la carrière avant la prise
#define CARRIERE_PRE_APPROCHE_MM 400.0f // point amont (détection obstacle encore active)
#define CARRIERE_RECUL_MM       150.0f  // recul après la prise
#define DEPOSE_APPROCHE_MM      100.0f  // décalage avant la dépose
#define DEPOSE_RECUL_MM         150.0f  // recul après la dépose
#define APPROCHE_VITESSE_PCT     15.0f  // vitesse des approches finales (%)
#define TIR_ROUE_G_PCT           30.0f  // roue canal 0 (%)
#define TIR_ROUE_D_PCT           30.0f  // roue canal 1 (%)
#define TIR_DUREE_MS             3000   // durée d'alimentation du ventilateur (ms)
#define TIR_ATTENDRE_PHASE_ATTAQUE  0
#define DEFAULT_SPEED_MMS   2000.0f    // mm/s
#define DEFAULT_ACCEL_MMS2  1500.0f   // mm/s²  — freinage en 320 mm depuis 800 mm/s
#define TURN_SPEED_MMS      2000.0f
#define TURN_ACCEL_MMS2     3000.0f
#define TABLE_WIDTH_MM      3000.0f   // axe X (horizontal)
#define TABLE_HEIGHT_MM     2000.0f   // axe Y (vertical, vers le bas)
#define TABLE_MARGIN_MM     100.0f    // épaisseur marge bord (filtre points LIDAR = murs)
#define ESSAI_WIDTH_MM      1000.0f
#define ESSAI_HEIGHT_MM      700.0f
#define TERRAIN_ESSAI       0
#define ANGLE_NORTH         90.0f
#define ANGLE_EAST           0.0f
#define ANGLE_SOUTH        270.0f
#define ANGLE_WEST         180.0f
#define LIDAR_BODY_DIST_MM  80.0f     // ignore points < 80 mm (intérieur du robot)
#define LIDAR_BLIND_L_START  75.0f    // début zone aveugle poteau gauche (°)
#define LIDAR_BLIND_L_END   105.0f    // fin   zone aveugle poteau gauche (°)
#define LIDAR_BLIND_R_START 255.0f    // début zone aveugle poteau droite (°)
#define LIDAR_BLIND_R_END   285.0f    // fin   zone aveugle poteau droite (°)
#define OBS_DETECT_DIST_MM  500.0f    // distance de détection devant/derrière
#define OBS_WIDTH_MM        200.0f    // largeur zone de détection (≥ largeur robot)
#define OBS_MIN_DIST_MM     60.0f     // distance projetée min dans la zone obstacle
#define OBS_CONFIDENCE_MIN  100       // seuil confiance point LIDAR
#define OBS_WAIT_MS          3000     // timeout attente dégagement adversaire (ms)
#define OBS_POLL_MS            20     // période vérification obstacle pendant go()
#define OBS_BACKUP_MM       100.0f    // recul après détection avant attente
#define OBS_STOP_ACCEL_MMS2 4000.0f   // décélération d'urgence (freinage agressif)
#define LIDAR_LED_DIST_MM   OBS_DETECT_DIST_MM  // seuil LEDs = seuil détection robot
#define MOTION_PERIOD_MS     10       // cadence de la boucle (100 Hz)
#define MOTION_KP_DIST       6.0f     // 1/s : mm/s par mm d'erreur de distance
#define MOTION_KP_ANG        8.0f     // 1/s : rad/s par rad d'erreur d'angle
#define MOTION_KI            0.0f     // 1/s² : intégrale, sur les deux boucles
#define MOTION_I_MAX        50.0f     // mm/s : saturation de l'intégrale (anti-windup)
#define MOTION_STOP_MM       1.0f     // tolérance d'arrivée en distance (mm)
#define MOTION_STOP_DEG      0.5f     // tolérance d'arrivée en angle (°)
#define MOTION_MIN_SPD       8.0f     // mm/s : vitesse mini de correction du résidu
#define MOTION_SETTLE_CYCLES 3        // cycles consécutifs dans la tolérance → arrivé
#define MOTION_SETTLE_MS   1500U      // après la fin du profil : abandon si non convergé
#define MOTION_HEADING_FREEZE_MM 50.0f // en ligne droite : cap figé sous cette distance restante
#define MOTION_ACT_LAG_MS      35     // retard commande → mouvement des pas à pas (file de la
#define STEP_LINEAR_ACCEL_MM   2.0f   // démarrage adouci : montée progressive de l'accélération
#define STEP_MIN_SPEED_MMS     4.0f   // sous cette vitesse : arrêt. Une vitesse plus faible met en
#define MOTION_CORR_MAX_MMS    150.0f // correction maxi par roue autour de la vitesse du profil
#define MOTION_STEPPER_ACCEL_K   1.2f  // accélération des pas à pas = K × celle du profil,
#define MOTION_STEPPER_ACCEL_MIN 1000.0f // … au moins ceci (mm/s²) : à vitesse lente, les
#define MOTION_MAX_ERR_MM      50.0f   // garde-fou : écart à la référence au-delà → arrêt
#define MOTION_MAX_ERR_DEG     20.0f   //   (dérive du centre en rotation : 0,6 × MAX_ERR_MM)
#define MOTION_MAX_HEADING_DEG 45.0f   //   en ligne droite (> MOTION_BLEND_MAX_DEG)
#define MOTION_CORNER_MM       50.0f   // point de passage : vitesse limitée pour que le robot
#define MOTION_SLIP_MM         15.0f   // glissement : écart roue codeuse ↔ pas émis toléré…
#define MOTION_SLIP_CYCLES     20      // … sur cette fenêtre (cycles de MOTION_PERIOD_MS)
#define MOTION_W_SLEW           8.0f   // rad/s² : variation maxi de la correction de cap en ligne droite
#define MOTION_PASS_MAX_DEG    60.0f   // parcours : coin franchi sans arrêt jusqu'à cet angle
#define MOTION_BLEND_MAX_DEG     30.0f // nouvelle cible en roulant : enchaînée sans arrêt si l'écart de cap est sous ce seuil
#define STALL_CONFIRM_MS    150U    // ms consécutives sans avance pour confirmer le stall
#define STALL_TIMEOUT_MS    2000U   // ms max pour atteindre la cible avant timeout (après dépassement)
#define STALL_THRESH_MM     0.5f    // mm/poll en dessous = considéré comme stall
#define MATCH_DURATION_MS  100000UL   // durée totale du match (100 s)
#define MATCH_ENDGAME_MS    85000UL   // déclenchement repli fin de match (85 s)
#define PCA9685_I2C_ADDR    0x40   // adresse PCA9685 (A0-A5 = GND)
#define PCF8574_I2C_ADDR    0x20   // adresse PCF8574 (A0-A2 = GND) — optionnel, non monté
#define FLYWHEEL_L_CHANNEL  0
#define FLYWHEEL_R_CHANNEL  1
#define ESC_MIN_US          1000   // impulsion arrêt (gaz mini)
#define ESC_MAX_US          2000   // impulsion plein gaz
#define ESC_ARM_MS          3000   // durée de gaz mini envoyée pour armer les ESC
#define FEEDER_PWM_PIN          19
#define FEEDER_LEDC_CHANNEL     2      // canal 0 = LIDAR (timer 0) → canal 2 (timer 1)
#define FEEDER_PWM_FREQ_HZ      25000
#define BRAS_G_OUVERT       75.0f
#define BRAS_D_OUVERT       25.0f
#define BRAS_G_PRISE        66.0f
#define BRAS_D_PRISE        33.0f
#define BRAS_G_REPOS        50.0f
#define BRAS_D_REPOS        50.0f
#define BRAS_INIT_G_EN_PREMIER   1      // position inconnue : 1 = G puis D, 0 = D puis G
#define BRAS_VITESSE_PCT_S  100.0f      // vitesse de déplacement (% de course / s)
#define BRAS_SEQ_DELAY_MS   300         // attente entre les deux bras (fin de course physique)
#define BOOT_SELFTEST_ENABLED       1
#define BOOT_FLYWHEEL_TEST_ENABLED  0
#define FLYWHEEL_TEST_PCT       30.0f   // vitesse max atteinte par le test lanceur (%)
#define LAUNCH_SPINUP_MS        1000    // rampe de montée en vitesse des roues (ms)
#define LAUNCH_SETTLE_MS         500    // stabilisation avant lancer (ms)
#define LAUNCH_DURATION_MS      3000    // durée par défaut d'alimentation des balles (ms)
#define LAUNCH_FEED_PCT        100.0f   // vitesse par défaut du ventilateur d'alimentation (%)
#define LAUNCH_TAIL_MS           500    // roues maintenues après arrêt du ventilateur (ms)
#define DISPLAY_SCL_PIN     4
#define DISPLAY_SDA_PIN     5
#define OLED_I2C_ADDR       0x3C      // adresse 7 bits SSD1306 (self-test)
#define DISPLAY_UPDATE_MS   500       // 2 Hz
#define TASK_LIDAR_CORE     0
#define TASK_LIDAR_PRIO     2
#define TASK_LIDAR_STACK    4096
#define TASK_STRATEGY_CORE  1
#define TASK_STRATEGY_PRIO  2
#define TASK_STRATEGY_STACK 4096
#define TASK_DISPLAY_CORE   1
#define TASK_DISPLAY_PRIO   1
#define TASK_DISPLAY_STACK  3072
#define TASK_WIFI_CORE      0         // Core 0 — priorité basse, ne bloque pas la stratégie
#define TASK_WIFI_PRIO      1
#define TASK_WIFI_STACK     8192
#define BTN_TIRETTE_PIN     14    // pull-up externe — LOW = tirette en place
#define BTN_TEAM_PIN        17    // pull-up interne — LOW = pressé
#define BTN_INIT_PIN         3    // pull-up interne — LOW = pressé
#define TIRETTE_STABLE_MS  150    // anti-rebond tirette : état stable avant prise en compte
#define NEO_PIN             46
#define NEO_COUNT            7
enum class Team : uint8_t { YELLOW, BLUE };
