Barbatronic/CDR-2027/(commit log)

2026-08-17 update for 2027-CDR init
    [Battery-test.FCStd, BlocOdometrie.FCStd, DriverBoardSupport.FCStd, GPIOExpanderSupport.FCStd, LateralActuator.FCStd, MF83.step, MainBoardSupport.FCStd, MatBalise.FCStd]
2026-09-21 Ajout du site de documentation (Jekyll, Just the Docs)
    Journal de bord avec un premier article sur les éléments de jeu
    (boulets et pierres), thème sombre, flux RSS et sections de
    documentation à remplir.
2026-09-21 Ajout du workflow de publication GitHub Pages
    Construit le site Jekyll du dossier DOCS et le déploie via GitHub Actions.
2026-09-22 Ajout de l'article de journal sur les essais de portes et de tours
    Essais rapides des constructions "porte" et "tour" en pierres, réalisés
    à la demande d'Astérix (RCVA) sur le Discord de la coupe. Photos et
    vidéo redimensionnées et nettoyées de leurs métadonnées (GPS, modèle
    d'appareil) avant publication.
2026-09-22 Ajout du support Model Viewer pour les modèles 3D
    Le script est chargé sur tout le site, avec un style de cadre cohérent
    avec le reste des articles (coins arrondis, bordure discrète).
2026-09-22 Ajout des sources CAD du lanceur à deux moteurs
    Modèle FreeCAD et plan de découpe laser de la maquette. Les sauvegardes
    FreeCAD (*.FCBak) sont désormais ignorées par git.
    [ball-launcher-test.FCStd]
2026-09-22 Ajout de l'article de journal sur le lanceur à deux moteurs
    Premier essai d'un lanceur de boulets à deux roues motorisées en
    boucle ouverte, avec photos du montage, vidéo de l'essai de tir et
    modèle 3D interactif du système.
2026-09-25 Ajout de l'article de journal sur le ventilateur d'alimentation des boulets
    Essai d'un ventilateur 12 V de 40 x 40 mm pour pousser les boulets dans
    un tube vertical, puis vers le lanceur à deux roues, avec photos et
    vidéos des essais.
2026-09-27 Ajout de l'article de journal sur le système de tir intégré
    Canal coudé imprimé en deux parties, support des rouleaux et du
    ventilateur, blocage des boulets dans le coude et essai de tir du
    canon intégré avec des roues de 44 mm.
2026-09-27 Ajout du modèle FreeCAD du système de tir intégré
    [ball-launcher.FCStd]
2026-09-27 Lien vers le modèle FreeCAD dans l'article du système de tir intégré
2026-09-27 update with a simplified model for 5 balls
    [Canon5Balles.3mf, ball-launcher-test.FCStd, ball-launcher.FCStd]
2026-09-28 Ajout de l'article de journal sur le tir intégré à 6 boulets
    Système imprimé en une seule pièce, ventilateur en bas, testé seul puis
    monté sur le robot, avec photos et vidéos des essais.
2026-09-28 Mise à jour du modèle FreeCAD du système de tir pour 6 boulets
    [ball-launcher.FCStd]
2026-09-28 Renommage du dossier de découpe laser en laser-cutting et mise à jour du lien dans le journal
2026-09-28 Ajout des fichiers CAD du manipulateur de cartons (FreeCAD, impression 3D, découpe laser)
    [box-manipulator-arm-manipulator-servo-support.3mf, box-manipulator-arm-manipulatorarm-gripper.3mf, box-manipulator-arm-manipulatorarm.3mf, box-manipulator.FCStd]
2026-09-29 feat(frw): firmware du robot différentiel repris de 2026, avec lanceur
    Base : firmware CDR 2026 (nadarbreicq/Differential-Robot-Firmware,
    commit 1bc464c), déplacement et navigation inchangés.
    - lanceur : deux roues à inertie sur ESC unidirectionnel (PCA9685,
    canaux 0 et 1) et ventilateur d'alimentation en PWM 25 kHz (GPIO 19)
    - launchBalls(pctL, pctR, durée, ventilo) : vitesse réglable par roue
    - self-test au boot (I2C, LIDAR, encodeurs, IO), PCF8574 optionnel
    - suppression des actionneurs et de la stratégie 2026, POI réduits
    aux zones de départ
    - UI web : curseurs lanceur et ventilateur, Stop tout, Test lanceur
2026-09-29 chore: convention de commit commune au dépôt, firmware inclus
2026-09-29 journal: essai du canon piloté par la carte du robot et un ESC
    - driver bimoteur sur le PCA9685, ventilateur en PWM sur la broche 19
    - essais à 100 %, 43 % et 15 % avec photos et vidéos
2026-09-29 fix: double slash dans le lien « Modifier cette page » des articles
    Surcharge du pied de page de Just the Docs : collections_dir vide
    ajoutait un « / » supplémentaire dans le chemin des articles.
2026-09-29 chore: skill de rédaction des articles du journal
    - procédure complète : dictée, médias, intégration, vérification
    - optimize-media.sh : réduction, effacement GPS, sauvegarde originaux
    - check-post.sh : build, médias manquants ou inutilisés, métadonnées
2026-09-29 feat(actuators): servos bas gauche et bas droit sur PCA canaux 2 et 3
    - aucun signal au boot, relâchés en fin de match
    - UI : curseurs Bas G / Bas D, « -- » tant que non commandés
    - servo non commandé transmis à -1 (NAN rendait le JSON invalide)
2026-09-29 feat(actuators): positions et séquences des bras bas
    - ouvrirBras (75/25), prendreBloc (66/33), reposBras (50/50)
    - déplacement simultané et interpolé ; un bras après l'autre seulement
    depuis une position inconnue (premier mouvement après le boot)
    - bras ouverts à l'initialisation : fermés, ils butent contre les bordures
    - UI : boutons Bras ouverts / Prise bloc / Bras repos
2026-09-29 strat: fond de carte et POI du règlement 2027 (Camelot)
    - fond de carte tiré du plan de l'annexe G.1 (sans cotes ni filigrane),
    recadré sur 3000 × 2000 via la grille du plan, 1200 × 800 px
    - 42 POI relevés sur le plan (±5 mm), convertis dans le repère 2026 :
    salle du trône, écuries, cours, tours, murs, douves, carrières
    - carrières : piles de 3 pierres couchées (coquille « verticalement »
    dans le texte BETA) ; 4e carrière à X=2300, asymétrie du plan à revoir
    - UI : libellés et couleurs par catégorie de POI
2026-09-29 strat: calage 2027 et séquence d'essai carrière → mur → tir
    - cotes robot 2027 (sabot inversé) : arrière 134,82 mm, avant 80,9 mm
    bras ouverts ; calage dans le coin du fond, en arrière, bras ouverts
    - fin de calage dans la salle du trône, orienté vers la carrière 1 / 4
    - prendreCarriere(poi, cap, décalage) : approche à 100 mm, détection
    obstacle coupée pour la fin (pierres vues par le LIDAR), prise, recul
    - deposerMur(poi) : orientation déduite du mur, approche depuis
    l'extérieur du château face à la cour
    - tirerDepuisCour : entrée par le mur 3, flanc gauche vers l'adversaire ;
    attente de la phase d'attaque (85 s) activable pour le match
2026-11-04 new PCB
2026-11-05 begin pcb
2026-11-07 docs: audits déplacements et interface web de novembre 2026
    - audit_motion : fin de mouvement exponentielle, cap non corrigé en
    translation, empattements mélangés, pistes A–G (trajectoire,
    polaire, UMBmark…)
    - audit_web : mode WIFI_LOG_ENABLED 0 qui ne compile pas, calibration
    modifiable en match, stats radar sur les mauvais côtés, constantes
    C++/JS divergées
2026-11-07 feat(config): environnements PlatformIO match et match_nowifi
    - section [env] commune, env de développement par défaut inchangé
    - match : WiFi en point d'accès et tir à la phase d'attaque
    - match_nowifi : sans WiFi, à compiler régulièrement
    - réglages de config.h surchargeables par -D (#ifndef)
    - fonctions vides du mode sans WiFi complétées (wifiLogPush,
    wifiLogLidar, wifiLogLidarAbs) : match_nowifi ne compilait plus
2026-11-07 fix: arrêt garanti à 100 s, relance sans redémarrage et arrêt UI
    - tâche taskMatchGuard (cœur 1, prio 5) : à 100 s, roues, lanceur et
    ventilateur coupés puis verrouillés, quoi que fasse la stratégie
    - verrous ESC, ventilateur et steppers, levés à la fin de la stratégie
    ou à la relance d'un match
    - relance sans redémarrer la carte : chrono et mode endgame remis à
    zéro (Robot::resetMatch)
    - arrêt et activation des moteurs depuis l'interface traités par la
    tâche chrono : effectifs aussi pendant la stratégie
    - stop match depuis l'interface : avance le chrono, même chemin que
    la fin de match normale
    - MatchPhase : phase du match lisible, distincte de RobotState
2026-11-07 fix(io): anti-rebond de la tirette
    Un changement d'état n'est pris en compte qu'après TIRETTE_STABLE_MS
    (150 ms) de lecture stable : un faux contact ou un rebond au retrait
    ne lance plus le match.
2026-11-07 fix(motion): empattement des roues motrices en rotation
    Les erreurs sont mesurées sur les roues codeuses (entraxe 189 mm) mais
    les commandes vont aux roues motrices (145,6 mm). La partie
    différentielle de la commande est mise à l'échelle wheelbase /
    encWheelbase, et le contrôleur de pose utilise l'entraxe moteur.
    Avant : rotations ×1,3 trop rapides et freinage au-delà de
    l'accélération réglée. Translations inchangées.
2026-11-07 fix(motion): réalignement vers la cible après un obstacle
    Après le recul, la reprise passe par la phase ALIGN avant TRANSLATE :
    le cap courant ne vise pas forcément la cible. La direction surveillée
    par la détection d'obstacle reste celle du trajet.
2026-11-07 tune(motion): filtre PCNT des encodeurs à 5 µs
    1000 → 400 cycles APB. 12,5 µs était trop proche du demi-cycle du
    signal A (~15 µs) d'une roue codeuse à 2600 mm/s en rotation rapide :
    risque de pas perdus.
2026-11-07 fix(wifi): calibration validée, refusée pendant le calage et le match
    - chaque valeur est contrôlée (nombre fini, mêmes plages que les
    champs de l'interface) : un diamètre à 0 n'est plus accepté
    - refus pendant le calage et le match, permis avant et après
    - en cas de refus, les valeurs réelles sont renvoyées et l'interface
    se corrige
2026-11-07 feat(ui): barre d'état phase, chrono, moteurs et mouvement
    - phase du match (MatchPhase) envoyée avec la pose, avec le chrono,
    l'état des moteurs (alimentés, verrouillés en fin de match)
    - barre en haut de la page : phase et consigne, chrono sur 100 s
    (orange à partir de 85 s), moteurs, mouvement en cours
    - contrôle des actionneurs basé sur la phase plutôt que sur le texte
    de l'état, icônes du cadenas corrigées
2026-11-07 fix(ui): angle LIDAR en repère robot pour le radar
    Le firmware envoie l'angle en repère robot (0° = avant, 90° = gauche),
    offset de calibration inclus, avec la même conversion que la détection
    d'obstacle. Le radar dessine l'avant en haut ; les indicateurs Avant et
    Arrière mesuraient auparavant les flancs droit et gauche.
2026-11-07 feat: terrain d'essai 1000 × 700 activable depuis l'interface
    - gTable : dimensions de la table en cours (match 3000 × 2000 ou
    essai 1000 × 700), bascule par l'interface hors calage et match
    - filtres LIDAR des bords (obstacle, LIDAR terrain) sur la table en
    cours
    - calage inchangé, puis parking au centre de la table d'essai ;
    stratégie et repli de fin de match sautés en mode essai
    - interface : quadrillage coté tous les 100 mm, POI masqués,
    encombrement du robot à l'échelle
    - TERRAIN_ESSAI fixe l'état au démarrage (0 par défaut)
2026-11-07 feat(motion): enregistrement de chaque mouvement pour l'interface
    - MotionRecorder : un échantillon par cycle de la boucle motion
    (~50 Hz, 20 s max, ~24 Ko) — phase, pose, vitesses commandées et
    mesurées par roue, erreurs de distance et d'angle, plafond de vitesse
    - démarré à chaque nouvelle cible (un blend prolonge l'enregistrement),
    arrêté à l'arrivée ou sur release()
    - envoi à la fin du mouvement par blocs de 32 échantillons, seulement
    si une page est connectée ; {"type":"rec_req"} redemande le dernier
2026-11-07 feat(ui): graphes du dernier mouvement, trace et emprise du robot
    - onglet MOTION : résumé, vitesses roues commandées / mesurées, erreurs
    de distance et d'angle, fond par phase, curseur commun, export CSV
    - terrain : trace des positions passées et chemin du dernier mouvement
    (bouton Trace, clic droit pour effacer)
    - robot dessiné à l'échelle (avant 80,9, arrière 134,8, largeur 232 mm)
    sur les deux tables ; largeur confirmée dans doc/context_llm.md
2026-11-07 chore: dossier logs des mouvements enregistrés
    Les CSV exportés depuis l'onglet MOTION sont suivis (exception à la
    règle *.csv de la racine), pour comparer avant / après chaque lot.
    Premier relevé : ligne droite de 607 mm puis rotation de 90°, avant
    réglage (référence du lot 1).
2026-11-07 tune(motion): seuil d'arrêt en rotation 2° → 0,5°
    Le relevé du 7 novembre montre une rotation de 90° arrêtée à 88,4° :
    le seuil de 2° laissait jusqu'à 2° d'erreur de cap. Coût estimé :
    environ 0,5 s de plus en fin de rotation, en attendant le profil de
    vitesse du lot 3.
2026-11-07 chore: relevé après réglage du seuil d'arrêt en rotation
    Même mouvement que le relevé de référence (ligne droite ~615 mm puis
    rotation de 90°), seuil de rotation à 0,5° : cap final -89,9° pour
    -90° (contre -88,4°), rotation 2,74 s au lieu de 2,44 s.
2026-11-07 feat(motion): calibration de l'odométrie, diamètres G/D et sauvegarde NVS
    - deux diamètres de roues codeuses : diamètre moyen + rapport D/G
    (ENC_WHEEL_RATIO), utilisés par l'odométrie, l'asservissement et
    l'enregistreur ; en translation, chaque roue vise ses propres comptes
    - sauvegarde de gCalib en NVS (calib_save), rechargée au démarrage,
    retour aux valeurs de config.h (calib_reset), état « enregistrée »
    dans calib_state
    - routines lancées depuis l'interface en attente d'init (calrun),
    référence = contact franc contre une bordure :
    ligne droite (diamètre moyen au mètre ruban), tours sur place en
    boucle ouverte à sens alterné (entraxes codeuses et moteur, ar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
2026-11-07 fix(strategy): contact bordure détecté par progression nette
    Après nettoyage des roues codeuses, les vibrations des moteurs qui
    forcent contre la bordure faisaient osciller les roues : le critère
    « moins de 0,5 mm par cycle sur chaque roue, en valeur absolue » ne
    voyait plus le blocage. Le blocage est maintenant une progression
    nette, dans le sens du mouvement, inférieure à 25 mm/s sur la fenêtre
    de confirmation pour les deux roues. Détection armée après 5 mm ou
    la durée d'accélération, et logs de la progression mesurée.
2026-11-07 feat(ui): onglet calibration, routines et corrections proposées
    - rapport D/G des roues codeuses, état d'enregistrement, boutons
    Enregistrer / Valeurs config.h / Copier pour config.h
    - routines ligne droite, tours et carrés avec consignes de placement
    - cadre « Corrections proposées » : moindres carrés e = u·R + v·S sur
    les observations (conservées dans le navigateur), un seul bouton
    applique entraxe et rapport puis efface les observations ; rapport
    calculé seulement avec des carrés et jamais hors 0,97–1,03
    - diagnostic par roue des tours (mesuré / commandé) avec historique
2026-11-07 tune(motion): calibration odométrie du 7 novembre
    Valeurs issues des routines du lot 2 sur la table d'essai :
    - diamètre moyen des roues codeuses 50,58 → 50,5821 mm
    - entraxe des roues codeuses 189,0 → 187,727 mm
    - entraxe des roues motrices 145,6 → 146,07 mm
    Rapport D/G non mesuré : la roue codeuse droite (imprimée en 3D)
    compte 0,84 % de moins en marche avant qu'en arrière, d'où ±0,4 %
    d'erreur de rotation selon le sens. À refaire avec les nouvelles
    roues.
2026-11-07 feat(lidar): détection d'obstacle évaluée dans la tâche LIDAR
    - module obstacle : une tâche demande la surveillance d'une direction
    (repère table), la tâche LIDAR évalue la zone toutes les 20 ms
    - résultat rendu seulement après une évaluation postérieure à la
    demande : changer de direction ne laisse pas traîner l'ancien résultat
    - modes simple et filtré bordures, comme dans Robot et MotionController
2026-11-07 feat(motion): asservissement par profil trapézoïdal et boucles distance/angle
    Remplace les deux PID par roue, qui visaient une position finale, par
    une trajectoire calculée dans le temps (lot 3 du plan).
    - profil trapézoïdal (accélération, palier, freinage), départ possible
    en mouvement pour enchaîner deux cibles
    - boucle à 100 Hz cadencée (vTaskDelayUntil), sans appel bloquant :
    v = v_ref + KP_DIST·e_dist, ω = ω_ref + KP_ANG·e_angle, réparties sur
    l'entraxe des roues motrices
    - ligne droite : distance en projection départ → cible, cap recalculé
    vers la cible jusqu'à 50 mm de l'arrivée puis figé ; rotation : centre
    maintenu sur place
    - vitesse envoyée = pro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
2026-11-07 fix(strategy): contact bordure armé sur la vitesse commandée
    À vitesse par défaut 800 mm/s, le recul de calage (10 %) accélère à
    80 mm/s² : après 5 mm, le robot roule encore sous 30 mm/s et passait
    pour bloqué. La détection s'arme maintenant quand la vitesse commandée
    dépasse le double du seuil sur toute une fenêtre, et le seuil est
    ramené à la moitié de la vitesse demandée pour un recul très lent.
2026-11-07 feat(ui): réglages de l'asservissement et profil sur le graphe
    - onglet calibration : KP distance, KP angle, KI, I max, tolérances
    en mm et en degrés, V min (≥ 4 mm/s)
    - dernier mouvement : vitesse du profil en gris sur le graphe des
    vitesses ; colonnes CSV reste_dist_mm, reste_angle_deg, v_ref_mms
2026-11-07 chore: relevés de mouvement du lot 3 (7 novembre)
    Essais sur table d'essai pendant la mise au point de la nouvelle
    commande : rotation finale emballée, moteurs figés par un pas lent,
    décrochage du moteur droit en marche arrière, puis mouvements corrects.
2026-11-07 feat(wifi): serveur WebSocket fiable et protégé
    - message config à la connexion : zone de détection, zones aveugles,
    dimensions des tables et du robot, durées de match, noms des états
    (config.h devient la seule source, l'interface n'en garde plus copie)
    - pose, mouvement, actionneurs, LIDAR et clic terrain écrits sur un
    cœur et envoyés depuis l'autre sous verrou : plus de trame à moitié
    mise à jour
    - trames LIDAR construites seulement si une page est connectée ; points
    absolus ralentis à 2 Hz pendant le match
    - origine vérifiée à la connexion (page servie par le robot ou outil
    sans en-tête Origin) ; jeton optionnel WS_TOKEN dans credentials.h
    - ping toutes les 5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
2026-11-07 fix(ui): cible cliquée bornée à la table
    Le firmware refuse une cible hors de la table en cours, moins la
    demi-largeur du robot (116 mm), au lieu d'envoyer le robot contre une
    bordure.
2026-11-07 feat(ui): interface robuste, utilisable au téléphone
    - constantes prises dans le message config du firmware (zone de
    détection 500 mm au lieu de 400, dimensions, durées, noms d'états) ;
    zones aveugles du LIDAR dessinées sur le radar
    - âge de la dernière donnée affiché, rouge au-delà de 1 s ; connexion
    rouverte au-delà de 4 s
    - jeton d'accès demandé et gardé dans le navigateur si le robot l'exige
    - une colonne sous 900 px de large ; cible et cap au doigt sur le terrain
    - logs : l'écran est purgé avec la liste au-delà de 1000 lignes
    - curseurs actionneurs : un envoi toutes les 100 ms au plus, valeur
    finale toujours envoyée
2026-11-07 feat(motion): parcours enchaînés, détection de glissement, démarrage adouci
    Lot 5 du plan.
    - profil avec vitesse d'arrivée non nulle (point de passage)
    - setPath / followPath : jusqu'à 8 points ; coin de moins de 60° pris
    en roulant : le segment s'arrête avant le point (coin coupé), le
    suivant repart avec un virage planifié (profil d'angle superposé à
    l'avance, vitesse tenue pendant le virage) ; au-delà, arrêt et
    rotation sur place
    - vitesse de passage telle que le robot avance d'au plus 100 mm pendant
    le virage et d'au plus la moitié du segment suivant
    - correction de cap à variation bornée (8 rad/s²) : un saut d'écart ne
    renverse plus les roues en un cycle (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
2026-11-07 fix(strategy): contact bordure par comparaison moteurs / codeuses
    Le blocage est reconnu quand les moteurs avancent (pas émis) d'au moins
    1,5 × le seuil pendant que les deux roues codeuses restent sous le
    seuil. Plus d'armement temporisé : pendant l'accélération, moteurs et
    codeuses avancent ensemble et rien ne se déclenche, quelle que soit la
    vitesse de calage. Les logs donnent aussi l'avance des moteurs.
2026-11-07 feat(strategy): routine de mesure de l'accélération maximale
    Onglet calibration, routine 4 : contact bordure, puis allers-retours de
    400 mm à la vitesse par défaut, accélération 1000, 1500, 2000… mm/s²
    jusqu'au premier mouvement non abouti. L'interface affiche la valeur
    tenue, la raison de l'échec et une accélération conseillée (80 %).
    Première mesure (8 novembre) : 1000 mm/s² tenus, échec à 1500 par
    décrochage du moteur droit en marche arrière.
2026-11-07 feat(ui): mode parcours sur le terrain
    Bouton « Parcours » : chaque clic ajoute un point numéroté (8 au plus),
    glisser sur le dernier donne le cap d'arrivée, « Envoyer » transmet le
    parcours ({"type":"path"}). Le firmware le refuse si un point sort de
    la table (marge de la demi-largeur du robot), sinon le lance avec
    Robot::setPath, aux mêmes conditions qu'un clic simple.
2026-11-07 fix(ui): animation du clic, variable inutilisée, cache de l'image du terrain
    - l'animation du clic ne relance plus une boucle par message reçu
    - needRender supprimée (jamais lue)
    - field.jpg (~200 Ko) gardée un jour par le navigateur
2026-11-07 chore: relevés de mouvement du lot 5 (7 et 8 novembre)
    Parcours successifs pendant la mise au point des enchaînements (arrêts
    aux coins, virage trop lent, décrochage au changement de segment, puis
    parcours fluide) et échec de la routine d'accélération à 1500 mm/s².
2026-11-07 pcb: carte principale 2027, Ethernet WIZ850io, buzzer sur MOSFET
    - module Ethernet WIZ850io (W5500) en SPI : CS, MOSI, MISO, SCLK, INT
    et RST dédiés ; symbole et empreinte ajoutés aux bibliothèques projet
    - buzzer commandé par un MOSFET AO3400A
    - liaison série TX / RX sortie sur connecteur
    - rail 3,3 V unifié sur +3V3, trous de fixation avec pastille
    - largeurs de pistes du projet : 0,3, 1,7 et 2 mm ; routage en cours
2026-11-08 pcb: routage de la carte principale 2027 et cotations
    - routage des pistes de la carte (environ 500 segments ajoutés)
    - cotations du contour : 198 × 59 mm
    - schéma : STEP_3 et DIR_3 reliés au connecteur du troisième driver
    - règles du projet : pastilles et perçages élargis, classe de piste
    0,3 mm, exclusions DRC des perçages hors plage
2026-11-09 3D part integration on PCB
